liquid-rocketry-illinois/actuation-pcb/bom/actuation.xlsx

Reference | Value | Footprint | MPN | Digi-Key P/N | Qty | Inventory (https://docs.google.com/spreadsheets/d/1Jm4x6jHwPd06mLJlg_sdBbzIBf3uTwiiXO537uxlBAc/edit) | Order Qty | Notes
C1, C3, C23-C32, C35-C42, C45, C46, C48, C58, C59 | 0.1uF | Capacitor_SMD:C_0603_1608Metric | GRM188R72A104KA35D | 490-3285-1-ND | 25 | 80 | 50
C2, C4, C21, C22, C43, C44, C47, C57, C65, C66 | 1uF | Capacitor_SMD:C_0603_1608Metric | GRT188R61H105KE13D | 490-12330-1-ND | 10 | 80 | 50 | inventory rated for 25V
C5-C20 | 10uF | Capacitor_SMD:C_1210_3225Metric | CL32B106KBJNNWE | 1276-3388-1-ND | 16 | 4 | 24
C33, C34 | 1nF | Capacitor_SMD:C_0603_1608Metric | GCJ188R72A102KA01D | 490-5777-1-ND | 2 | 90 | 10
C49-C51 | 6.8nF | Capacitor_SMD:C_0603_1608Metric | GRM1885C1H682JA01D | 490-11477-1-ND | 3 | 0 | 10
C52, C53, C56 | 10uF | Capacitor_SMD:C_1206_3216Metric | CL31B106KBHNNNE | 1276-6767-1-ND | 3 | 4 | 10 | inventory rated for 50V
C54, C55 | 10nF | Capacitor_SMD:C_0603_1608Metric | GRT1885C1E103JA02J | 490-GRT1885C1E103JA02JCT-ND | 2 | 90 | 10 | inventory rated for 50V
C60 | 3.3nF | Capacitor_SMD:C_0603_1608Metric | GRM1885C1H332JA01D | 490-6385-1-ND | 1 | 0 | 10
C61 | 68nF | Capacitor_SMD:C_0603_1608Metric | GCJ188R71H683KA12D | 490-5799-1-ND | 1 | 0 | 10
C62, C63, C68 | 22uF | Capacitor_SMD:C_1206_3216Metric | GRM31CR71A226KE15L | 490-5309-1-ND | 3 | 6 | 10 | inventory rated for 10V
C64, C67 | 10uF | Capacitor_SMD:C_0805_2012Metric | GRM21BR71A106KA73L | 490-10516-1-ND | 2 | 80 | 10 | inventory rated for 25V
D1 | PESD5V0L1BA,115 | Diode_SMD:D_SOD-323 | PESD5V0L1BA,115 | 1727-3833-1-ND | 1 | 0 | 5
D2 | PESD3V3L1BA,115 | Diode_SMD:D_SOD-323 | PESD3V3L1BA,115 | 1727-3825-1-ND | 1 | 0 | 5
D3-D18, D46 | B2100A-13-F | Diode_SMD:D_SMA | B2100A-13-F | B2100A-13-FDICT-ND | 17 | 8 | 24
D19-D34 | ACT CH1-CH16 | LED_SMD:LED_0603_1608Metric | LTST-C191KFKT | 160-1445-1-ND | 16 | 0 | 24 | orange led
D35, D51, D44, D45, D47 | CHK FB/CTRL PWR/FB PWR/HOT PWR/COLD PWR | LED_SMD:LED_0603_1608Metric | LTST-C191KGKT | 160-1446-1-ND | 5 | 0 | 20 | have 3 of LTST-C190TGKT
D36, D48, D49 | CHK HOT/ARMED/ENERGIZE CTRL | LED_SMD:LED_0603_1608Metric | LTST-C191KRKT | 160-1447-1-ND | 3 | 0 | 10 | red led
D37-D42 | CHK SAF/FB CH1-CH3/VDET CH1-CH2 | LED_SMD:LED_0603_1608Metric | LTST-C191TBKT | 160-1647-1-ND | 6 | 8 | 20 | blue led
D43 | SMAJ40CA-13-F | Diode_SMD:D_SMA | SMAJ40CA-13-F | SMAJ40CA-FDICT-ND | 1 | 3 | 2
D50 | ENERGIZED | LED_SMD:LED_0603_1608Metric | LTW-C191DS5 | 160-2239-1-ND | 1 | 6 | 10 | white led
D52 | SMAJ28CAQ-13-F | Diode_SMD:D_SMA | SMAJ28CAQ-13-F | SMAJ28CAQ-13-FDICT-ND | 1 | 0 | 3
J1 | ACTUATION | actuation:182-009-213R561 | 182-009-213R561 | 182-109FE-ND | 1 | enough | 0 | DSUB
J2-J17 | ACT CH1-CH16 | actuation:XT30U-M | XT30U-M | ~ | 16 | 30 | 0 | LCSC
J18-J20 | FB CH1-CH3 | actuation:1935174 | 1935174 | 277-1578-ND | 3 | 0 | 10
J21-J22 | VDET CH1-CH2 | actuation:1935161 | 1935161 | 277-1667-ND | 2 | 0 | 10
J23, J26 | PWR IN/SAFETY | actuation:XT90PW-M | XT90PW-M | ~ | 2 | 4 | 0 | LCSC
J24-J25, J27-J29 | PWR PROT/PWR 3.3V/ACT HOT/ACT COLD | Connector_AMASS:AMASS_XT60-M_1x02_P7.20mm_Vertical | XT60-M | ~ | 5 | 20 | 0 | LCSC, 10 each of C98733 and C129184
K1 | J115F11C | actuation:J115F11C | J115F11CH12VDCSH1.5U | 2449-J115F11CH12VDCSH1.5U-ND | 1 | 1 | 2 | big relay
L1 | 4.7uH | Inductor_SMD:L_Vishay_IHLP-2020 | IHLP2020CZER4R7M11 | 541-1238-1-ND | 1 | 0 | 5
Q1 | SI7220 NMOS | Package_SO:Vishay_PowerPAK_1212-8_Dual | SI7220DN-T1-GE3 | SI7220DN-T1-GE3CT-ND | 1 | 1 | 3
Q2 | NMOS | Package_TO_SOT_SMD:SOT-23-3 | PMV40UN2R | 1727-1900-1-ND | 1 | 0 | 5
R2, R4, R5, R7 | 604R | Resistor_SMD:R_0603_1608Metric | RC0603FR-07604RL | 311-604HRCT-ND | 4 | 0 | 20
R3, R6 | 120R | Resistor_SMD:R_0603_1608Metric | RC0603FR-07120RL | 311-120HRCT-ND | 2 | 0 | 20
R8, R9, R68-R75, R93 | 4.7k | Resistor_SMD:R_0603_1608Metric | RT0603FRE074K7L | YAG1238CT-ND | 11 | 0 | 100
R10-R25, R42-R47, R54, R55, R82, R83, R94 | 270R | Resistor_SMD:R_0603_1608Metric | RC0603FR-07270RL | 311-270HRCT-ND | 27 | 0 | 100
R26-R41, R60-R67, R84, R95, R98 | 470R | Resistor_SMD:R_0603_1608Metric | RC0603FR-07470RL | 311-470HRCT-ND | 27 | 0 | 100
R48, R50, R90, R91 | 47k | Resistor_SMD:R_0603_1608Metric | RT0603DRE0747KL | 311-2592-1-ND | 4 | 0 | 20
R49, R51 | 20k | Resistor_SMD:R_0603_1608Metric | AT0603DRD0720KL | 311-2107-1-ND | 2 | 0 | 20
R52, R53, R56, R58 | 100k | Resistor_SMD:R_0603_1608Metric | RT0603DRE07100KL | 311-2395-1-ND | 4 | 0 | 20
R57, R59 | 13k | Resistor_SMD:R_0603_1608Metric | RT0603DRE0713KL | 311-2422-1-ND | 2 | 0 | 20
R76 | 1.87M | Resistor_SMD:R_0603_1608Metric | RC0603FR-071M87L | 13-RC0603FR-071M87LCT-ND | 1 | 90 | 0 | 1.87M 1% 1/10W 0603
R77 | 32.4k | Resistor_SMD:R_0603_1608Metric | RT0603BRD0732K4L | YAG1636CT-ND | 1 | 8 | 10 | 32.4k 0.1% 1/10W 0603
R78 | 510k | Resistor_SMD:R_0603_1608Metric | RC0603FR-07510KL | 311-510KHRCT-ND | 1 | 90 | 0 | 510k 1% 1/10W 0603
R79, R80 | 10R | Resistor_SMD:R_0603_1608Metric | RC0603FR-0710RL | 311-10.0HRCT-ND | 2 | 90 | 0 | 10 1% 1/10W 0603
R81 | 5.1k | Resistor_SMD:R_0603_1608Metric | AC0603FR-075K1L | YAG3621CT-ND | 1 | 8 | 10 | 5.1k 0.1% 1/10W 0.603
R85 | 200k | Resistor_SMD:R_0603_1608Metric | AC0603FR-07200KL | YAG3575CT-ND | 1 | 0 | 10
R86, R96, R97 | 10k | Resistor_SMD:R_0603_1608Metric | RC0603FR-0710KL | 311-10.0KHRCT-ND | 3 | 90 | 0 | 10k 1% 1/10W 0603
R87 | 9.31k | Resistor_SMD:R_0603_1608Metric | RT0603DRE079K31L | 311-2691-1-ND | 1 | 0 | 10
R88 | 69.8k | Resistor_SMD:R_0603_1608Metric | RT0603DRD0769K8L | 311-69.8KDCT-ND | 1 | 0 | 10
R89 | 22.1k | Resistor_SMD:R_0603_1608Metric | RT0603BRD0722K1L | YAG1590CT-ND | 1 | 0 | 10
R92 | 1k | Resistor_SMD:R_0603_1608Metric | RC0603FR-071KL | 311-1.00KHRCT-ND | 1 | 85 | 0 | 1k 1% 1/10W 0603
RV1, RV2 | 10k | Potentiometer_SMD:Potentiometer_Bourns_3224W_Vertical | 3224W-1-103E | 3224W-103ECT-ND | 2 | 0 | 4
U1 | TPD4E02B04DQA | Package_SON:USON-10_2.5x1.0mm_P0.5mm | TPD4E02B04DQAR | 296-43875-1-ND | 1 | 0 | 5 | TI sample?
U2 | PCA9615 | Package_SO:TSSOP-10_3x3mm_P0.5mm | PCA9615DPZ | 568-PCA9615DPZCT-ND | 1 | 4 | 0 | out of stock :(
U3-U18, U39 | TLP241A | actuation:TLP241A | TLP241A(TP1,F | TLP241A(TP1FCT-ND | 17 | 1 | 24
U19, U20, U33 | PCA9534 | Package_SO:TSSOP-16_4.4x5mm_P0.65mm | PCA9534PWR | 296-21764-1-ND | 3 | 0 | 6 | TI sample?
U21-U26, U29, U30 | TLP2366 | actuation:TLP2366 | TLP2366(V4-TPL,E | TLP2366(V4-TPLECT-ND | 8 | 0 | 12
U27, U28 | TLV7031 | Package_TO_SOT_SMD:SOT-353_SC-70-5 | TLV7031QDCKRQ1 | 296-TLV7031QDCKRQ1CT-ND | 2 | 0 | 6 | TI sample?
U31, U32 | 74LVC1G126 | Package_TO_SOT_SMD:SOT-23-5 | 74LVC1G126GV,125 | 1727-6066-1-ND | 2 | 0 | 6
U34 | SN74LVC541A | Package_SO:TSSOP-20_4.4x6.5mm_P0.65mm | SN74LVC541APWR | 296-8521-1-ND | 1 | 0 | 3 | TI sample?
U35 | TLI4971 | Package_SON:Infineon_PG-TISON-8-5 | TLI4971A050T5UE0001XUMA1 | 448-TLI4971A050T5UE0001XUMA1CT-ND | 1 | 0 | 2
U36 | LTC4367 | Package_DFN_QFN:DFN-8-1EP_3x3mm_P0.5mm_EP1.65x2.38mm | LTC4367IDD-1#PBF | 505-LTC4367IDD-1#PBF-ND | 1 | 3 | 0 | out of stock :( Analog sample?
U37 | ADS1110 | Package_TO_SOT_SMD:SOT-23-6 | ADS1110A1IDBVT | 296-14462-1-ND | 1 | 0 | 2 | TI sample?
U38 | AP64350 | Package_SO:SOIC-8-1EP_3.9x4.9mm_P1.27mm_EP2.62x3.51mm | AP64350SP-13 | 31-AP64350SP-13CT-ND | 1 | 0 | 3
U40 | LP5912-3.3DRV | Package_SON:WSON-6-1EP_2x2mm_P0.65mm_EP1x1.6mm | LP5912-3.3DRVR | 296-47214-1-ND | 1 | 0 | 3 | TI sample?
 |  |  |  |  |  | Digi-Key cart | https://www.digikey.com/short/b8pdp9ph
