liquid-rocketry-illinois/actuation-pcb/actuation-3d/SI7220DN-T1-GE3.step

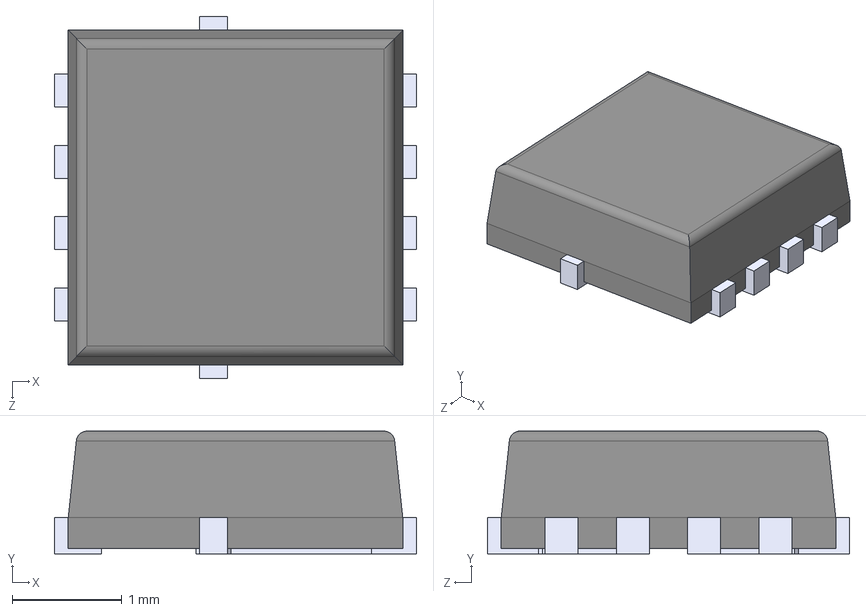
[picture p1: CAD file, 2023-03-06]
actuation-3d/SI7220DN-T1-GE3.step
3.30 x 1.12 x 3.30 mm
