liquid-rocketry-illinois/actuation-pcb/actuation-3d/3224W-1-103E.step

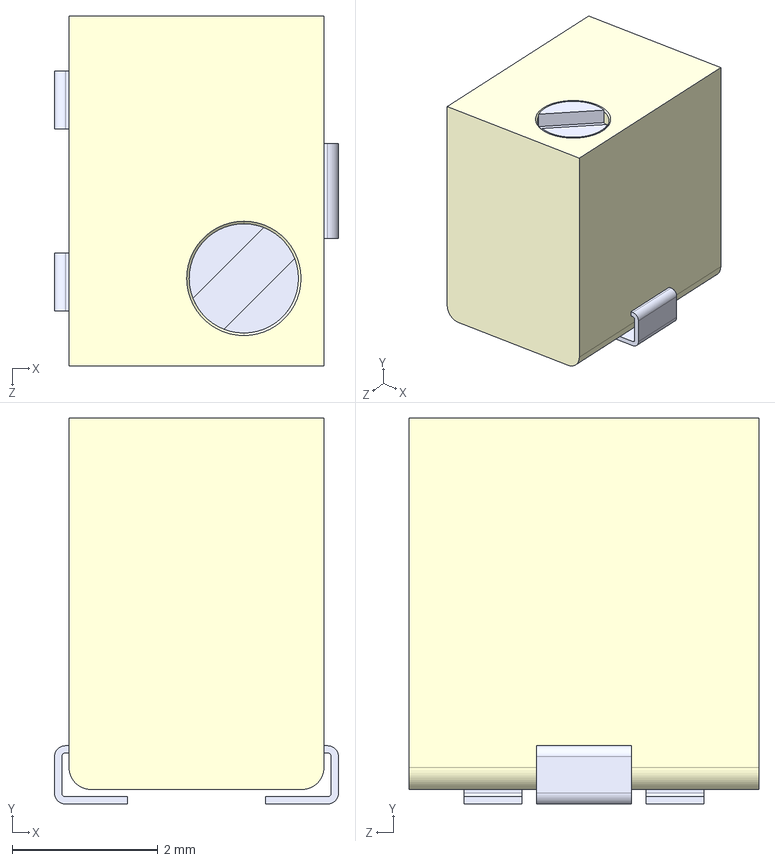
[picture p2: CAD file, 2023-01-27]
actuation-3d/3224W-1-103E.step
3.90 x 5.30 x 4.80 mm
