liquid-rocketry-illinois/actuation-pcb/actuation-3d/Relay_J115F.step

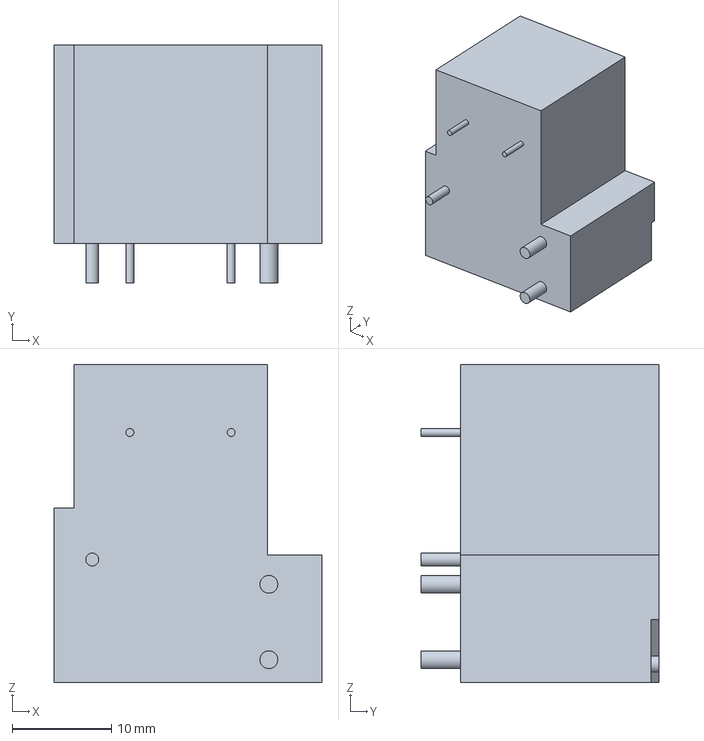
[picture p3: CAD file, 2023-01-24]
actuation-3d/Relay_J115F.step
27.0 x 24.0 x 32.0 mm
