liquid-rocketry-illinois/actuation-pcb/actuation-3d/XT30U-M.step

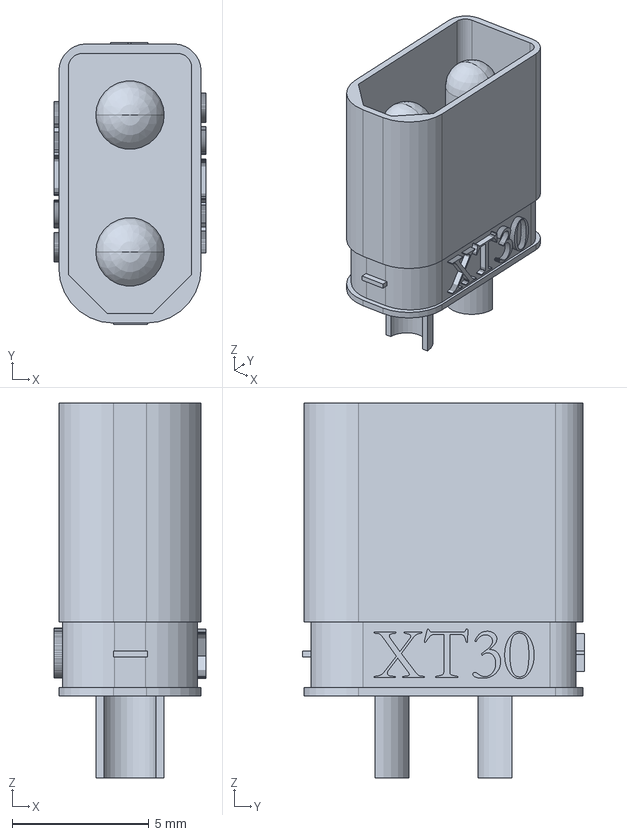
[picture p4: CAD file, 2023-01-22]
actuation-3d/XT30U-M.step
5.54 x 10.3 x 13.7 mm
