liquid-rocketry-illinois/actuation-pcb/actuation-3d/XT90PW-M-new.step

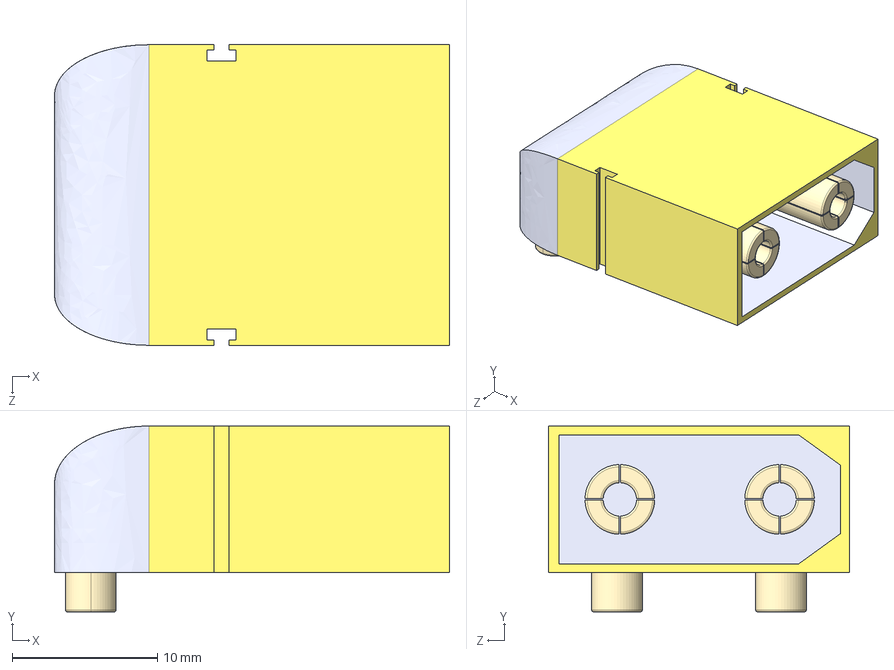
[picture p5: CAD file, 2023-01-16]
actuation-3d/XT90PW-M-new.step
27.2 x 12.8 x 20.7 mm
