liquid-rocketry-illinois/actuation-pcb/actuation-3d/XT90PW-M.step

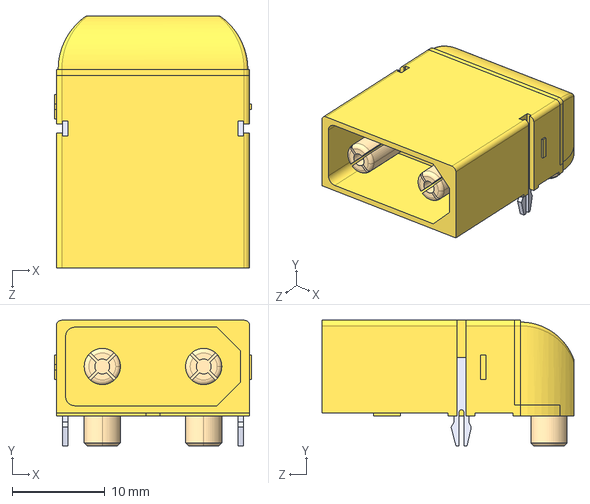
[picture p6: CAD file, 2023-01-16]
actuation-3d/XT90PW-M.step
21.2 x 13.5 x 27.1 mm
