liquid-rocketry-illinois/actuation-pcb/actuation-3d/IHLP2020.step

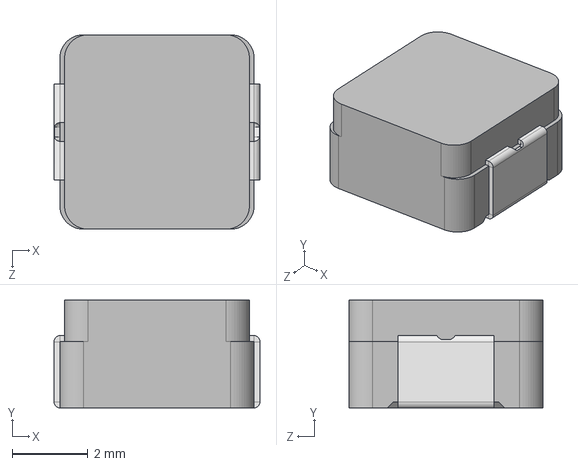
[picture p7: CAD file, 2023-01-06]
actuation-3d/IHLP2020.step
5.45 x 2.86 x 5.15 mm
