liquid-rocketry-illinois/actuation-pcb/actuation-3d/182-009-213.step

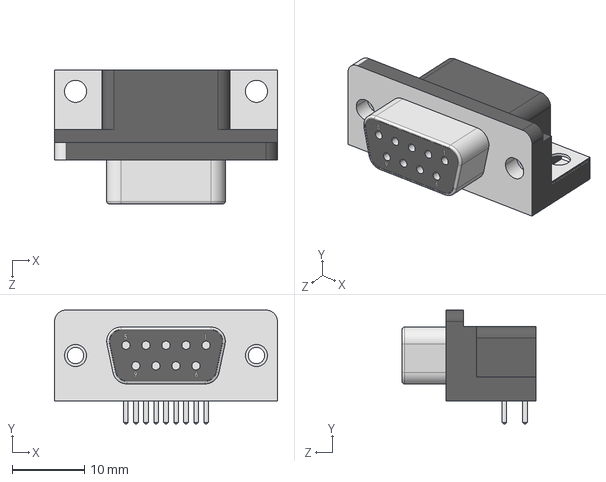
[picture p8: CAD file, 2023-01-06]
actuation-3d/182-009-213.step
30.8 x 15.7 x 18.5 mm
