liquid-rocketry-illinois/actuation-pcb/actuation-3d/TLP2366.step

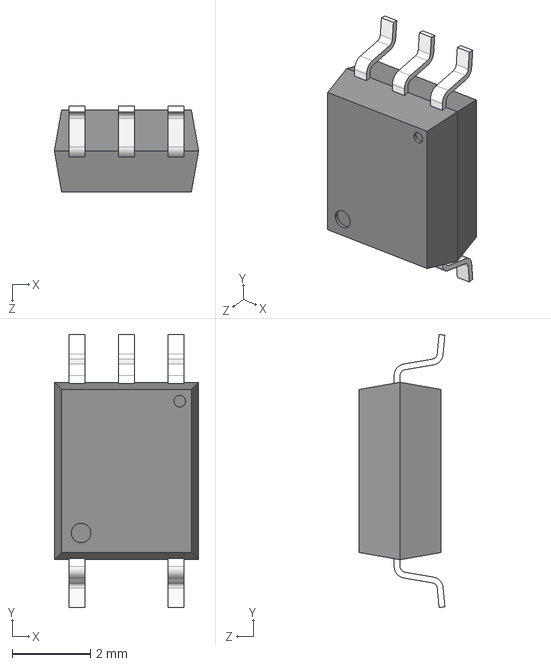
[picture p9: CAD file, 2023-01-06]
actuation-3d/TLP2366.step
3.70 x 7.00 x 2.20 mm
