liquid-rocketry-illinois/actuation-pcb/actuation-3d/TLI4971A050T5UE0001XUMA1--3DModel-STEP-56544.step

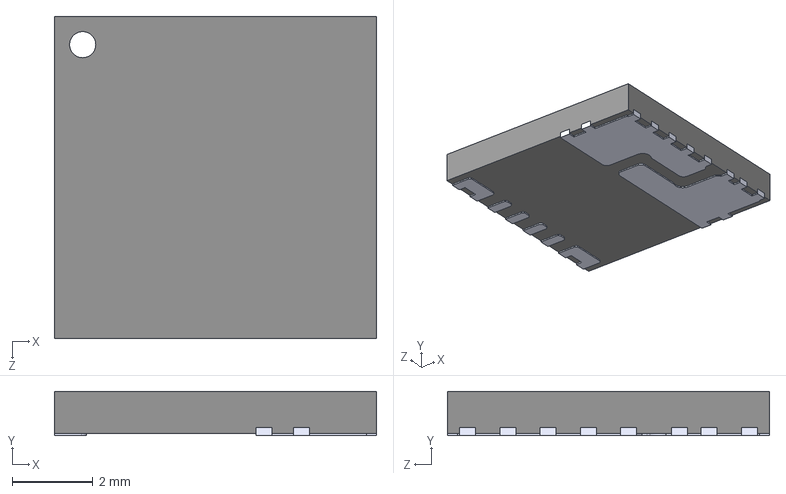
[picture p10: CAD file, 2023-01-06]
actuation-3d/TLI4971A050T5UE0001XUMA1--3DModel-STEP-56544.step
8.00 x 1.10 x 8.00 mm
