liquid-rocketry-illinois/actuation-pcb/actuation-3d/TLP241A.step

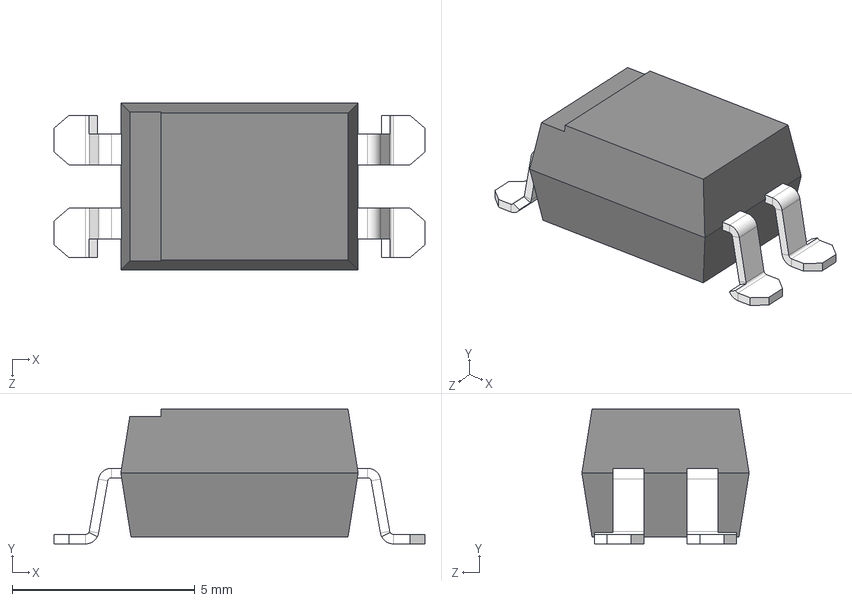
[picture p11: CAD file, 2023-01-06]
actuation-3d/TLP241A.step
10.2 x 3.69 x 4.58 mm
