liquid-rocketry-illinois/actuation-pcb/actuation-3d/1935161.step

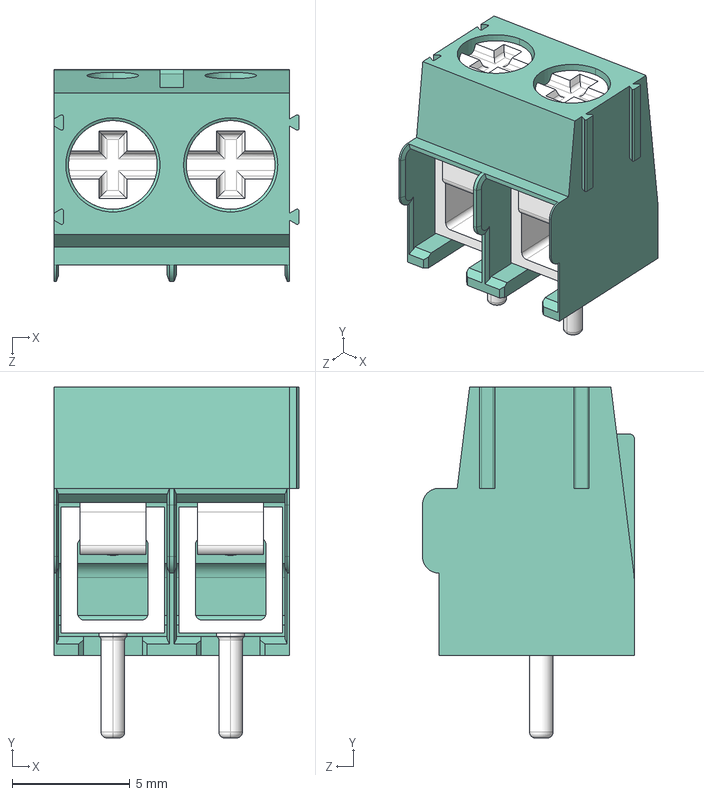
[picture p12: CAD file, 2023-01-22]
actuation-3d/1935161.step
10.4 x 14.9 x 9.00 mm
