liquid-rocketry-illinois/actuation-pcb/actuation-3d/1935174.step

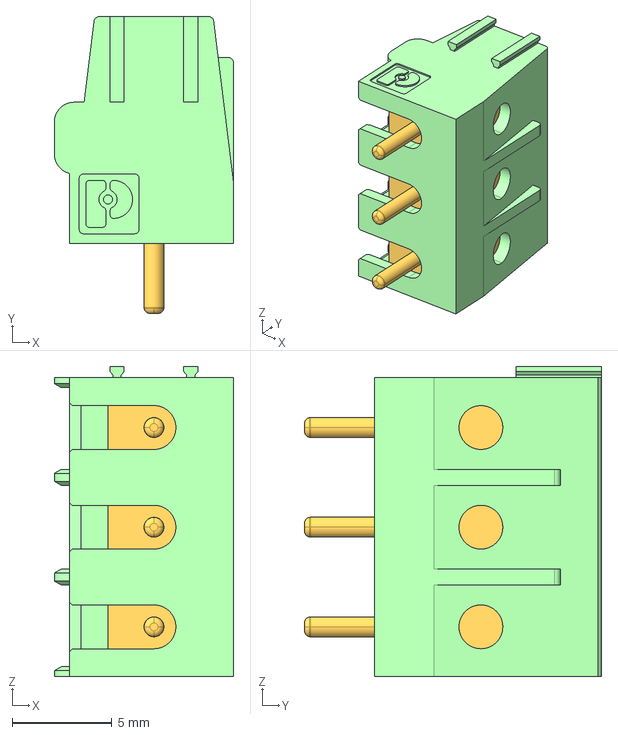
[picture p13: CAD file, 2023-01-22]
actuation-3d/1935174.step
9.00 x 14.9 x 15.6 mm
