liquid-rocketry-illinois/actuation-pcb/actuation-3d/1751251.step

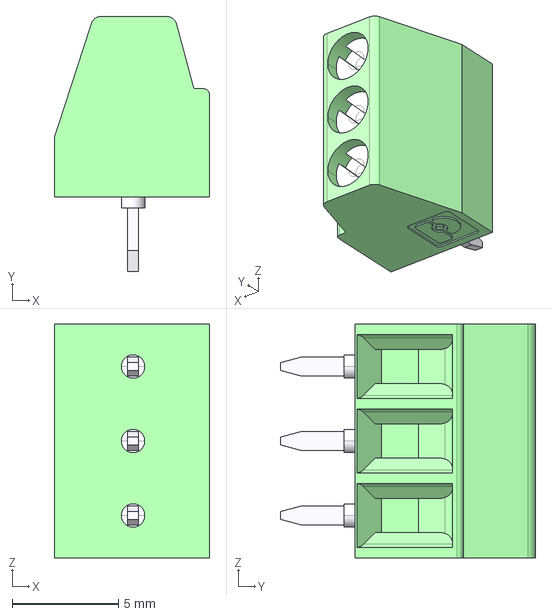
[picture p14: CAD file, 2023-01-04]
actuation-3d/1751251.step
7.30 x 12.0 x 11.0 mm
