liquid-rocketry-illinois/actuation-pcb/actuation-3d/1773976.step

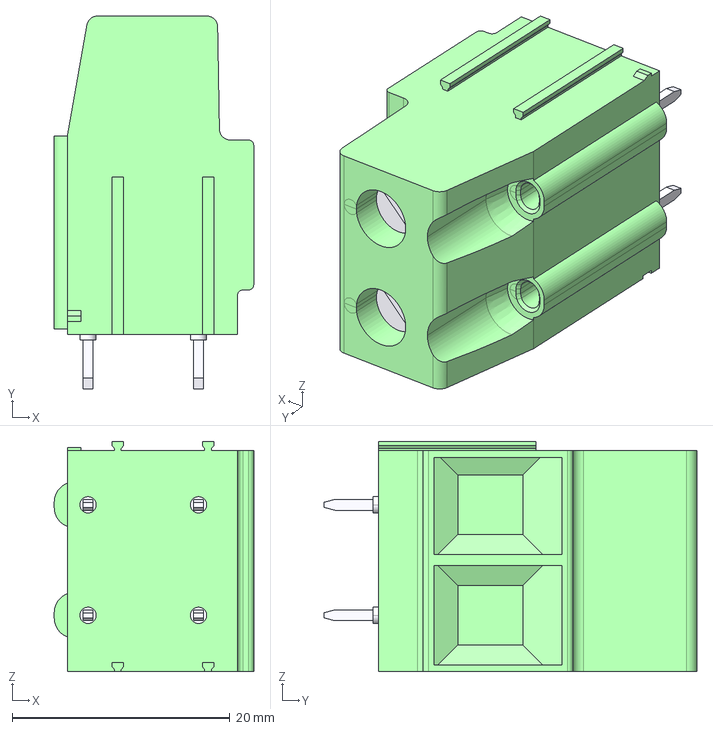
[picture p15: CAD file, 2023-01-04]
actuation-3d/1773976.step
18.4 x 34.3 x 21.2 mm
