liquid-rocketry-illinois/actuation-pcb/actuation-3d/1751248.step

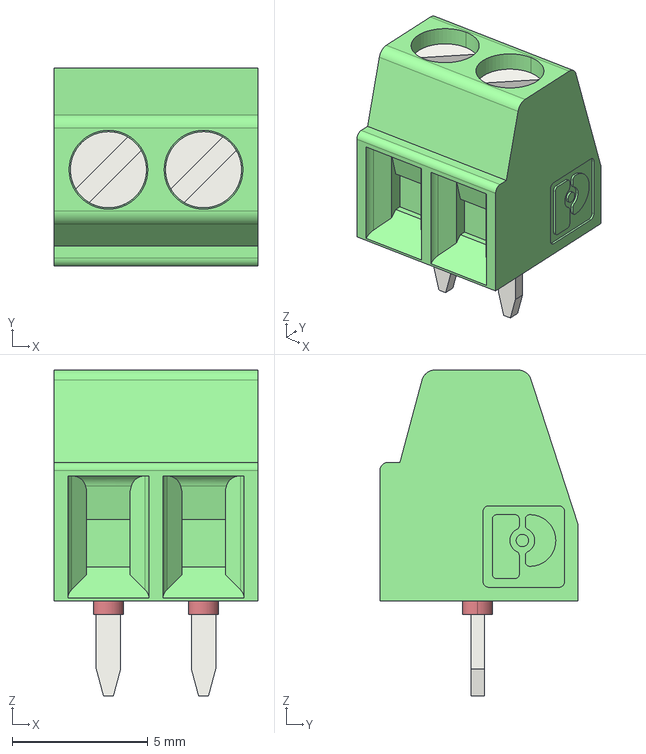
[picture p16: CAD file, 2023-01-04]
actuation-3d/1751248.step
7.50 x 7.30 x 12.0 mm
