liquid-rocketry-illinois/actuation-pcb/actuation.pdf

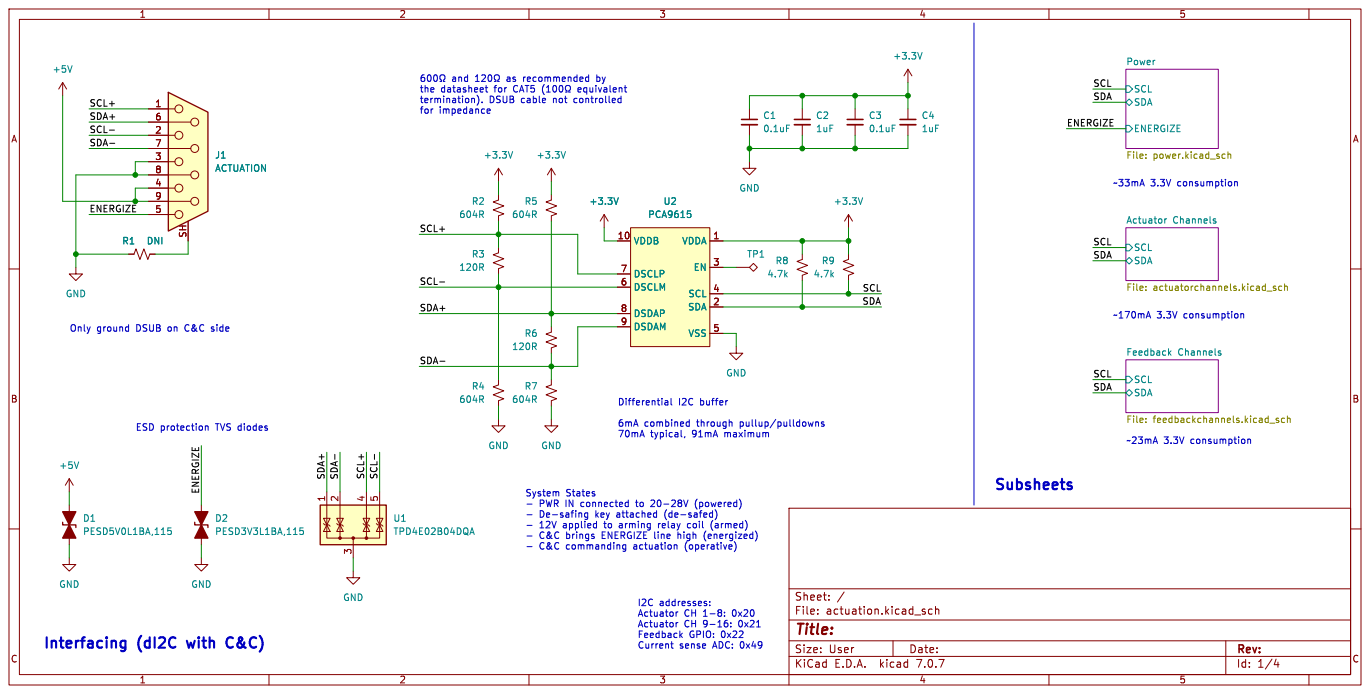
[picture p17: page 1]

Power File: power.kicad_sch GND

SCL Actuator Channels File: actuatorchannels.kicad_sch SCL SDA

Feedback Channels File: feedbackchannels.kicad_sch SDA

Only ground DSUB on C&C side

- 12V applied to arming relay coil (armed)
- C&C brings ENERGIZE line high (energized)

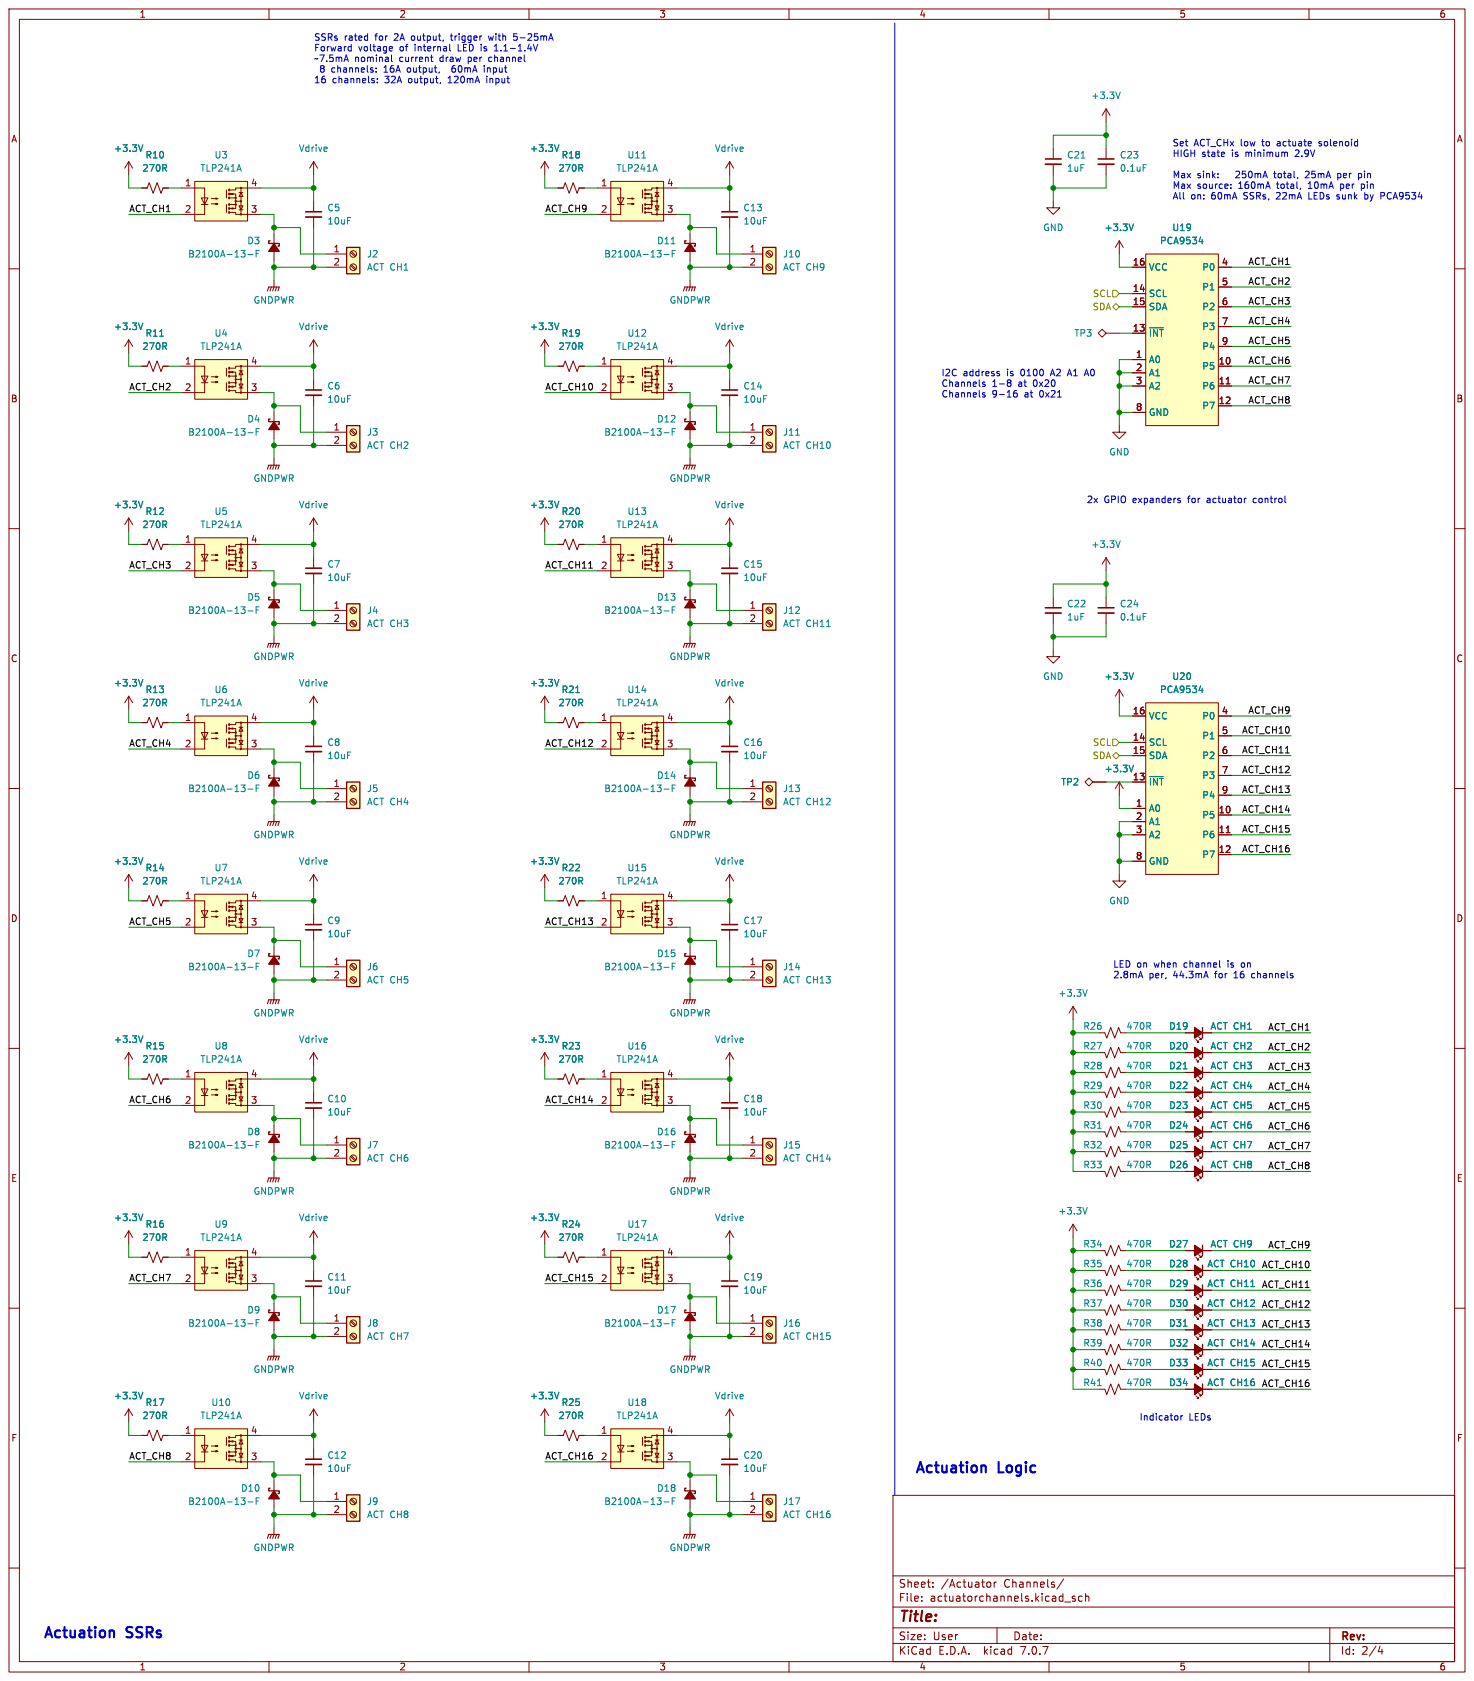
[picture p18: page 2]

SSRs rated for 2A output, trigger with 5-25mA

LED on when channel is on
2.8mA per, 44.3mA for 16 channels

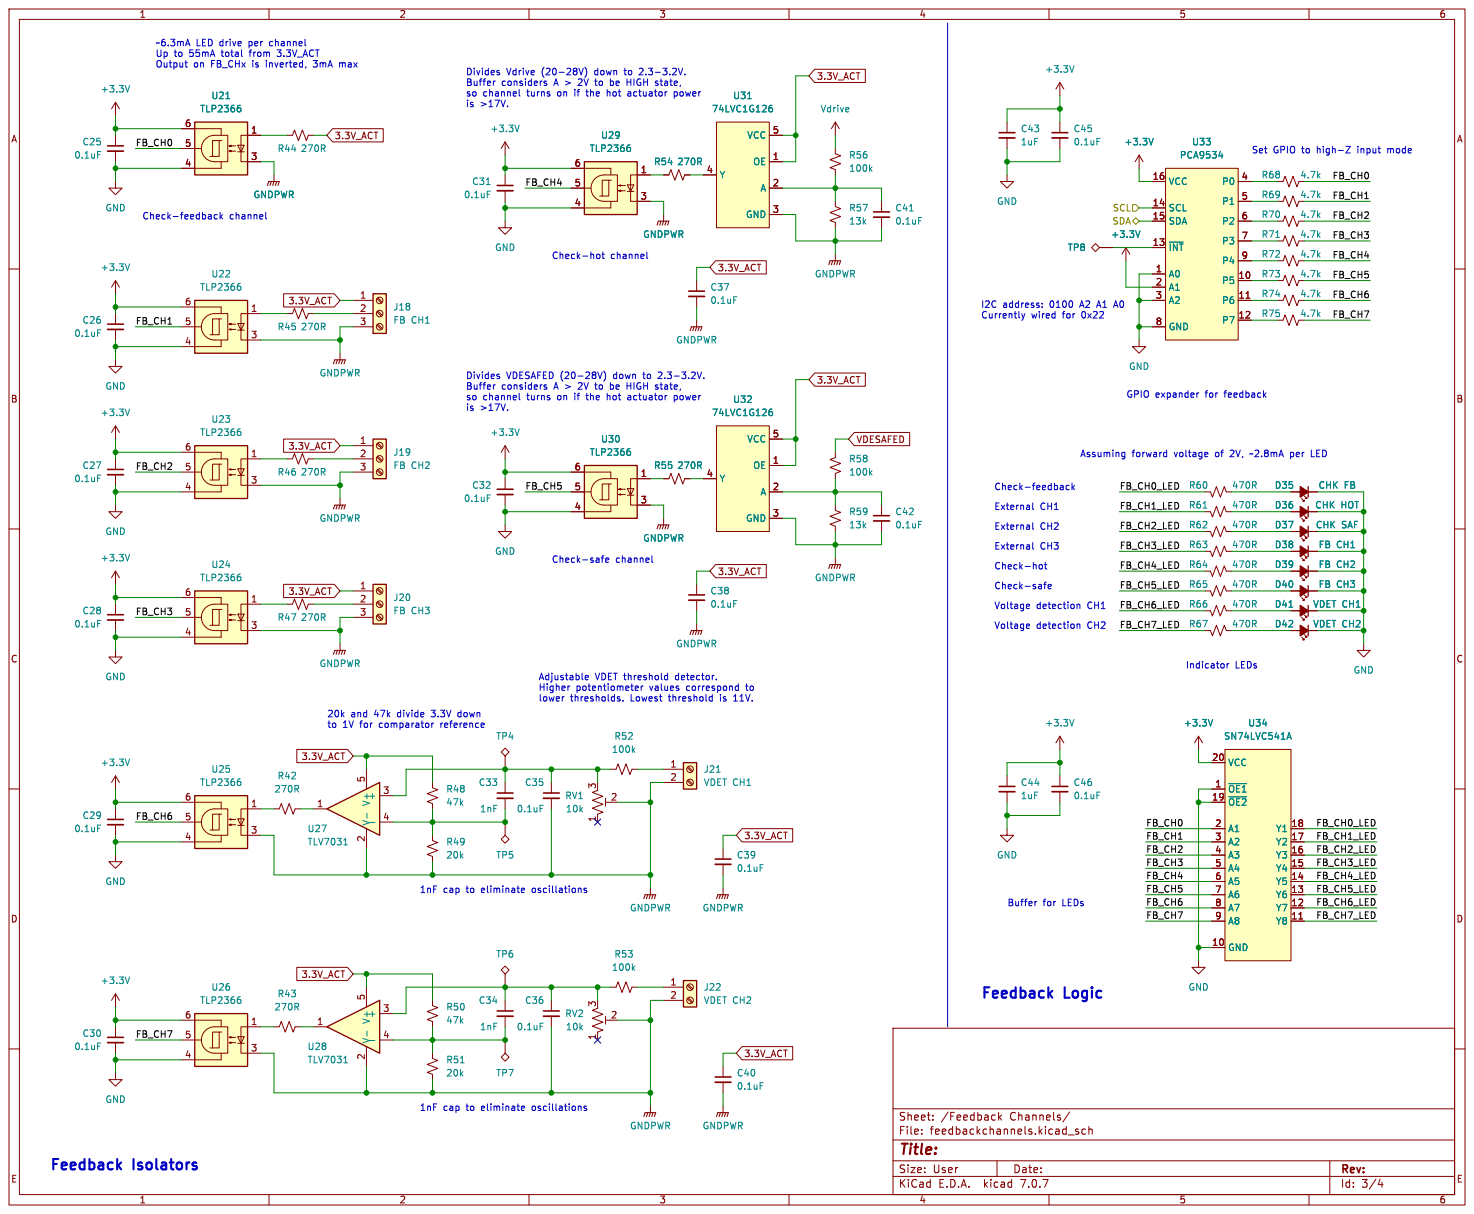
[picture p19: page 3]

Buffer for LEDs Feedback Logic

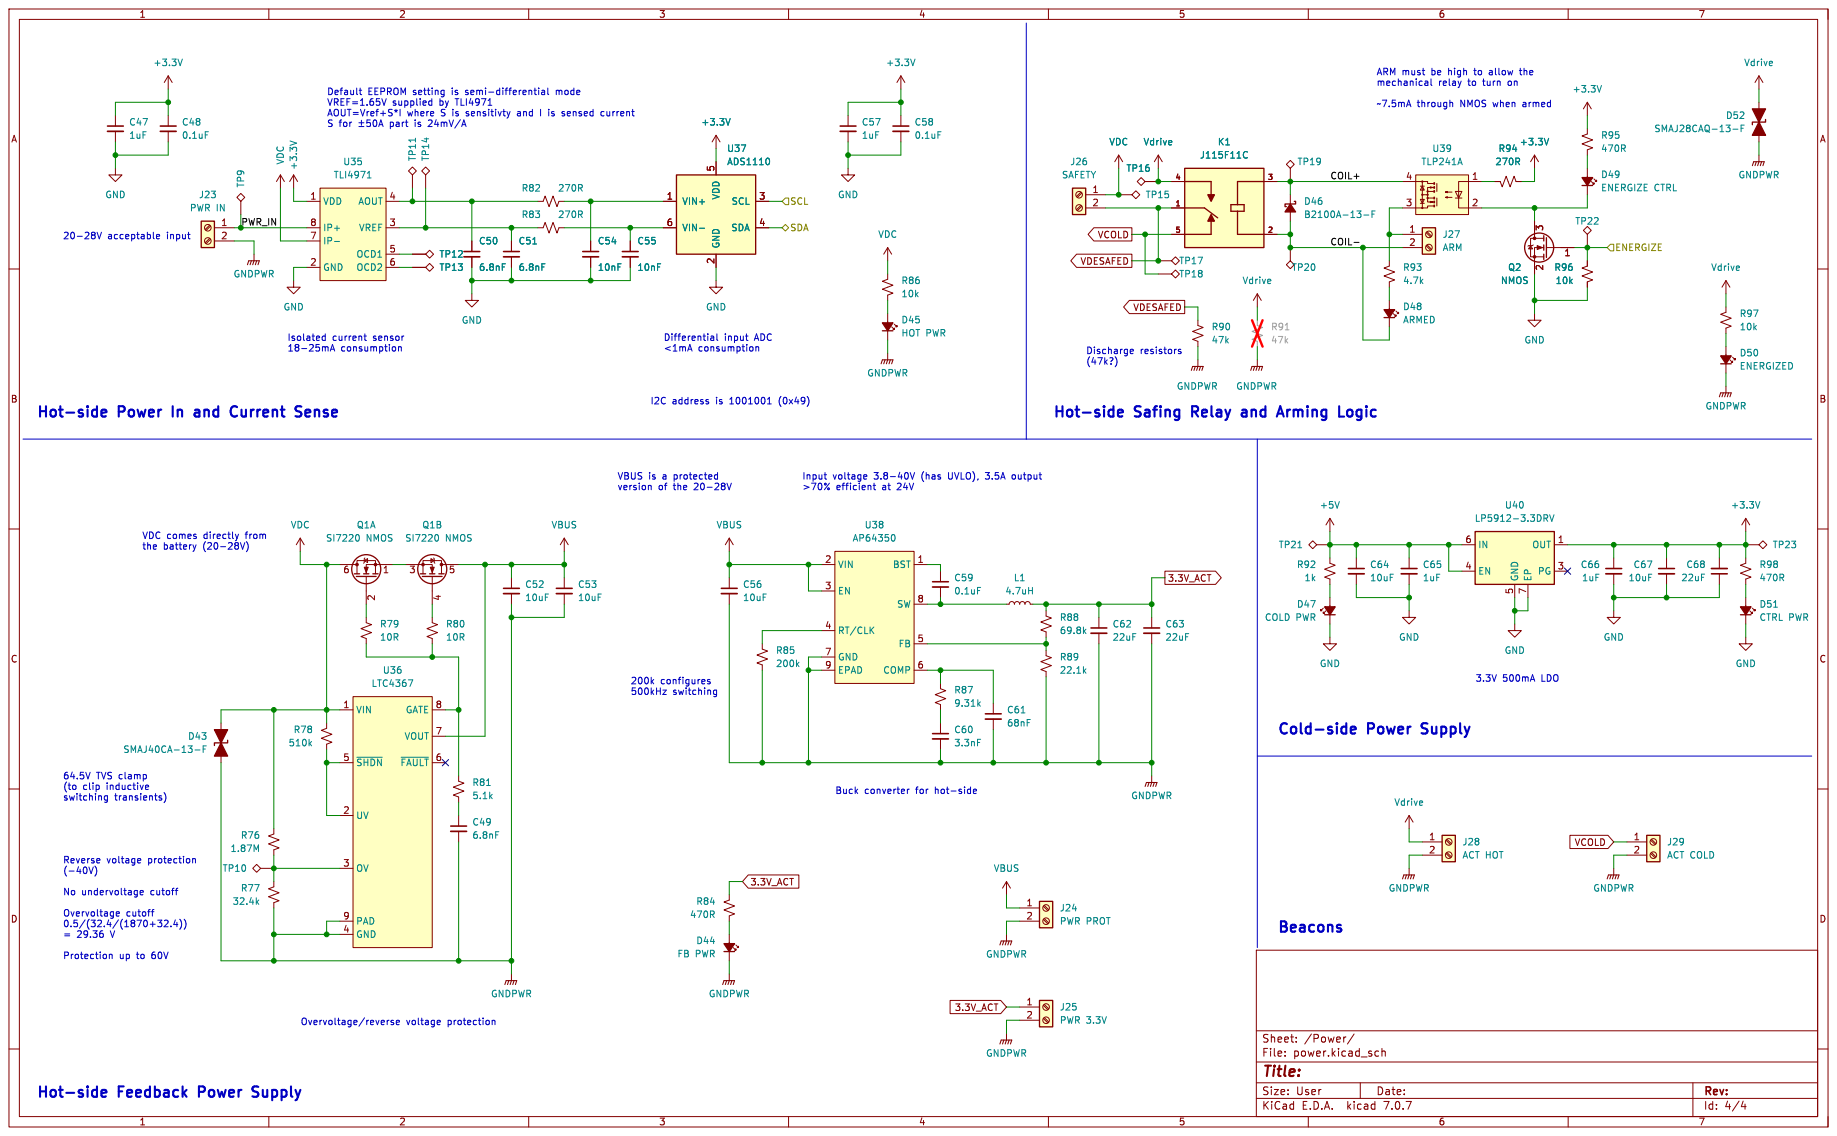
[picture p20: page 4]

COIL+ PWR_IN
Id: 4/4 Title: File: power.kicad_sch Sheet: /Power/ TP9

COIL- VBUS is a protected
