liquid-rocketry-illinois/actuation-pcb/actuation.kicad_pcb

## KiCad design actuation.kicad_pcb (2023-03-16)

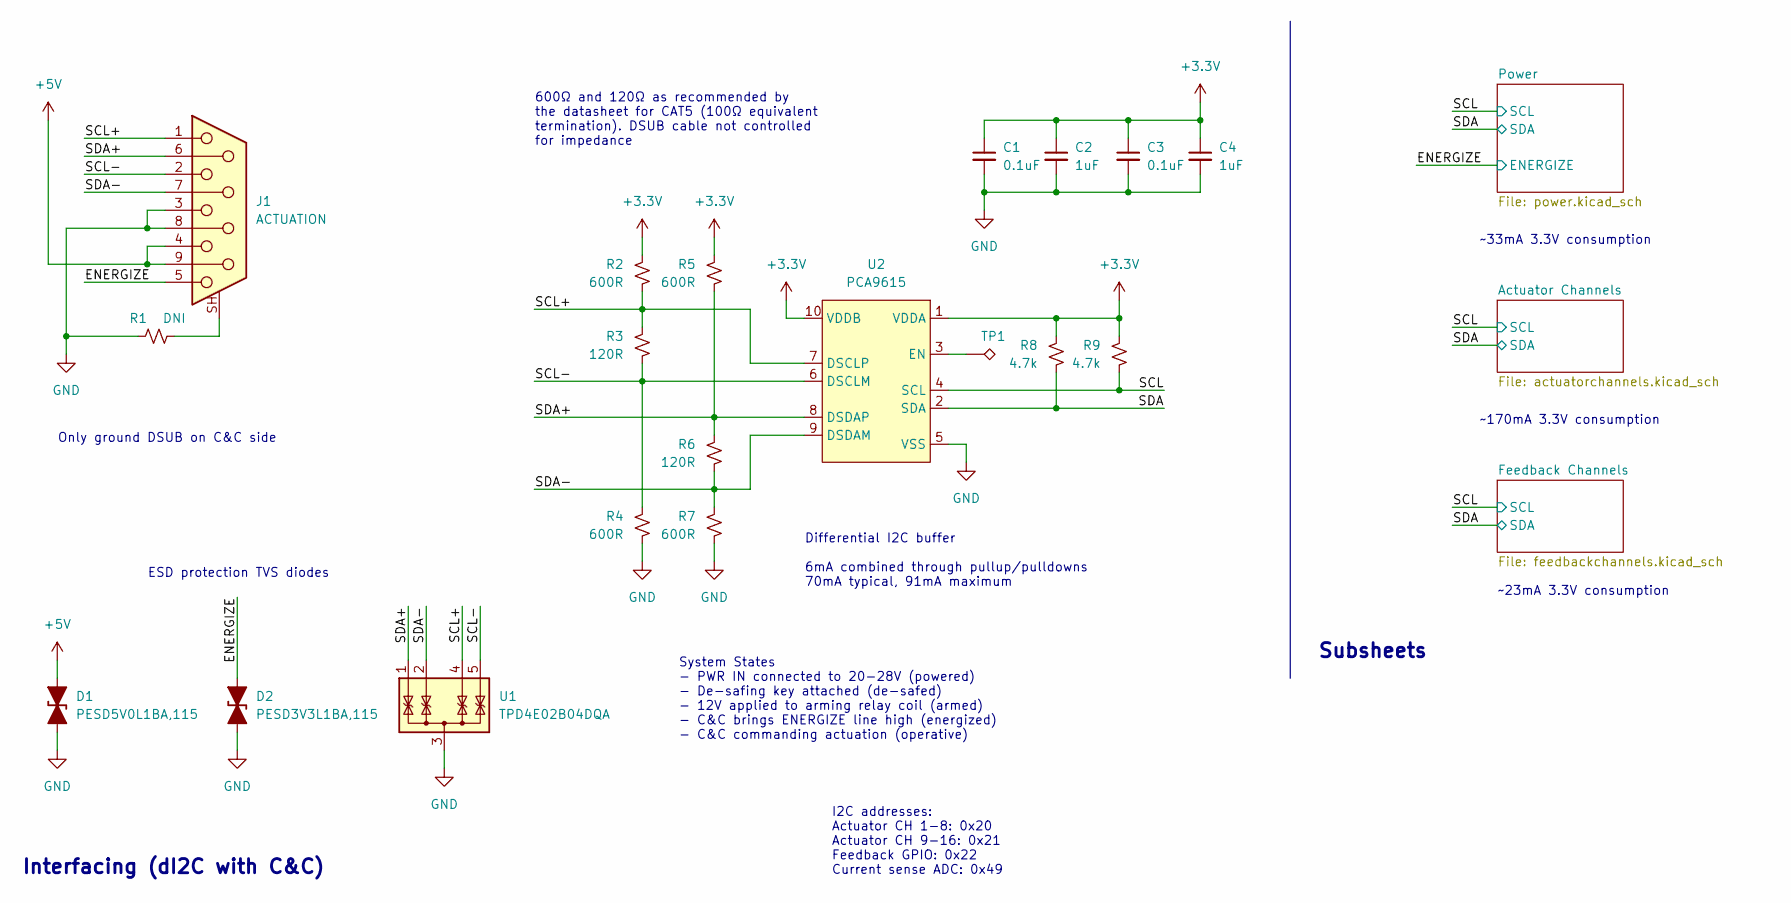
[picture p21: schematic actuation.kicad_sch]

Parts:
C1, C3: 0.1uF; C_0603_1608Metric
C2, C4: 1uF; C_0603_1608Metric
D1: PESD5V0L1BA,115; D_SOD-323; MPN PESD3V3L1BA,115
D2: PESD3V3L1BA,115; D_SOD-323; MPN PESD3V3L1BA,115
J1: ACTUATION; 182-009-213R561; MPN 182-009-213R561
R1: DNI; R_0603_1608Metric; MPN RC0603JR-070RL
R2, R4, R5, R7: 600R; R_0603_1608Metric
R3, R6: 120R; R_0603_1608Metric
R8, R9: 4.7k; R_0603_1608Metric
TP1: TestPoint_Alt; TestPoint_Pad_D2.0mm
U1: TPD4E02B04DQA; USON-10_2.5x1.0mm_P0.5mm; MPN TPD4E02B04DQAR
U2: PCA9615; TSSOP-10_3x3mm_P0.5mm; MPN PCA9615DPZ

Connections:
+3.3V: C1.1, C2.1, C3.1, C4.1, R2.1, R5.1, R8.1, R9.1, U2.1 (VDDA), U2.10 (VDDB); also elsewhere on the board
+5V: D1.2 (A2), J1.4, J1.9; also elsewhere on the board
/ENERGIZE: D2.2 (A2), J1.5; also elsewhere on the board
/SCL: R9.2, U2.4 (SCL); also elsewhere on the board
/SCL+: J1.1, R2.2, R3.1, U1.4 (IO3), U2.7 (DSCLP)
/SCL-: J1.2, R3.2, R4.1, U1.5 (IO4), U2.6 (DSCLM)
/SDA: R8.2, U2.2 (SDA); also elsewhere on the board
/SDA+: J1.6, R5.2, R6.1, U1.1 (IO1), U2.8 (DSDAP)
/SDA-: J1.7, R6.2, R7.1, U1.2 (IO2), U2.9 (DSDAM)
GND: C1.2, C2.2, C3.2, C4.2, D1.1 (A1), D2.1 (A1), J1.3, J1.8, R1.1, R4.2, R7.2, U1.3 (G), U1.8 (G), U2.5 (VSS); also elsewhere on the board
unnamed: J1.SH (PAD), R1.2
unnamed: TP1.1, U2.3 (EN)

Notes on the sheet:
~170mA 3.3V consumption
Interfacing (dI2C with C&C)
Subsheets
600Ω and 120Ω as recommended by the datasheet for CAT5 (100Ω equivalent termination). DSUB cable not controlled for impedance
~23mA 3.3V consumption
Only ground DSUB on C&C side
I2C addresses: Actuator CH 1-8: 0x20 Actuator CH 9-16: 0x21 Feedback GPIO: 0x22 Current sense ADC: 0x49
ESD protection TVS diodes
~33mA 3.3V consumption
System States - PWR IN connected to 20-28V (powered) - De-safing key attached (de-safed) - 12V applied to arming relay coil (armed) - C&C brings ENERGIZE line high (energized) - C&C commanding actuation (operative)
Differential I2C buffer 6mA combined through pullup/pulldowns 70mA typical, 91mA maximum

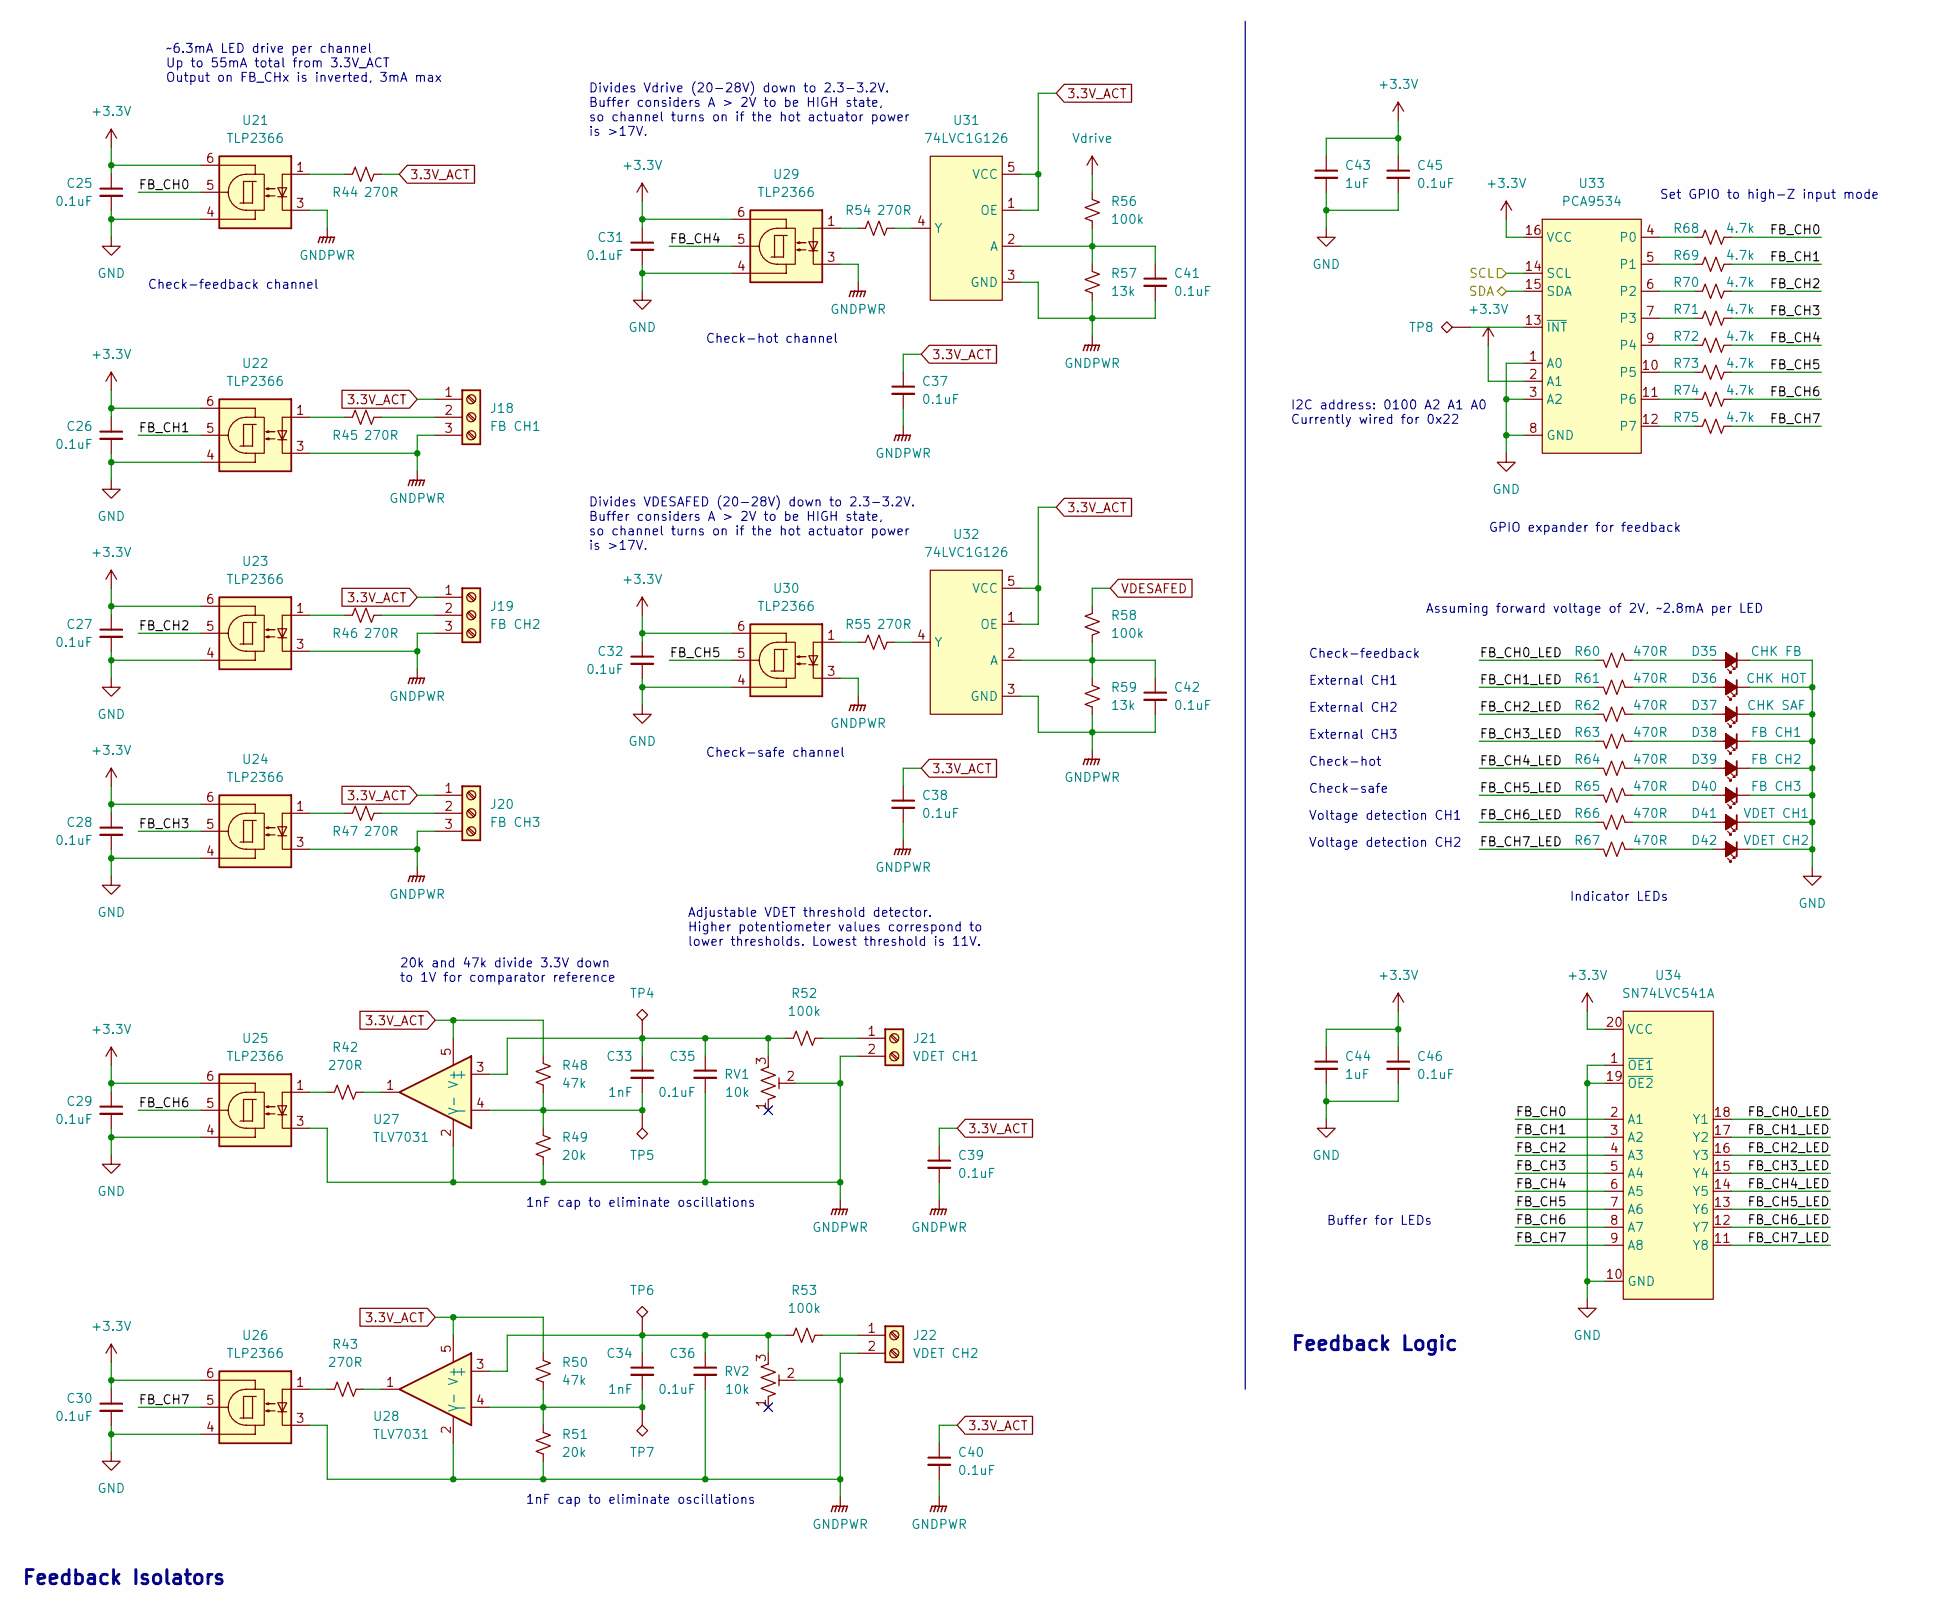
[picture p22: schematic feedbackchannels.kicad_sch]

Parts:
C25, C26, C27, C28, C29, C30, C31, C32, C35, C36, C37, C38, C39, C40, C41, C42, C45, C46: 0.1uF; C_0603_1608Metric
C33, C34: 1nF; C_0603_1608Metric
C43, C44: 1uF; C_0603_1608Metric
D35: CHK FB; LED_0603_1608Metric; MPN LTST-C191KGKT
D36: CHK HOT; LED_0603_1608Metric; MPN LTST-C191KRKT
D37: CHK SAF; LED_0603_1608Metric; MPN LTST-C191TBKT
D38: FB CH1; LED_0603_1608Metric; MPN LTST-C191TBKT
D39: FB CH2; LED_0603_1608Metric; MPN LTST-C191TBKT
D40: FB CH3; LED_0603_1608Metric; MPN LTST-C191TBKT
D41: VDET CH1; LED_0603_1608Metric; MPN LTST-C191TBKT
D42: VDET CH2; LED_0603_1608Metric; MPN LTST-C191TBKT
J18: FB CH1; 1935174; MPN 1935174
J19: FB CH2; 1935174; MPN 1935174
J20: FB CH3; 1935174; MPN 1935174
J21: VDET CH1; 1935161; MPN 1935161
J22: VDET CH2; 1935161; MPN 1935161
R42, R43, R44, R45, R46, R47, R54, R55: 270R; R_0603_1608Metric; MPN RC0603FR-07270RL
R48, R50: 47k; R_0603_1608Metric
R49, R51: 20k; R_0603_1608Metric
R52, R53, R56, R58: 100k; R_0603_1608Metric
R57, R59: 13k; R_0603_1608Metric
R60, R61, R62, R63, R64, R65, R66, R67: 470R; R_0603_1608Metric
R68, R69, R70, R71, R72, R73, R74, R75: 4.7k; R_0603_1608Metric
RV1, RV2: 10k; Potentiometer_Bourns_3224W_Vertical; MPN 3224W-1-103E
TP4, TP5, TP6, TP7, TP8: TestPoint_Alt; TestPoint_Pad_D2.0mm
U21, U22, U23, U24, U25, U26, U29, U30: TLP2366; MPN TLP2366(V4-TPL,E
U27, U28: TLV7031; SOT-353_SC-70-5; MPN TLV7031QDCKRQ1
U31, U32: 74LVC1G126; SOT-23-5; MPN 74LVC1G126GV,125
U33: PCA9534; TSSOP-16_4.4x5mm_P0.65mm; MPN PCA9534PWR
U34: SN74LVC541A; TSSOP-20_4.4x6.5mm_P0.65mm; MPN SN74LVC541APWR

Connections:
3.3V_ACT: C37.1, C38.1, C39.1, C40.1, J18.1, J19.1, J20.1, R44.2, R48.1, R50.1, U27.5 (V+), U28.5 (V+), U31.1 (OE), U31.5 (VCC), U32.1 (OE), U32.5 (VCC); also elsewhere on the board
+3.3V: C25.1, C26.1, C27.1, C28.1, C29.1, C30.1, C31.1, C32.1, C43.1, C44.1, C45.1, C46.1, U21.6, U22.6, U23.6, U24.6, U25.6, U26.6, U29.6, U30.6, U33.2 (A1), U33.16 (VCC), U34.20 (VCC); also elsewhere on the board
/Feedback Channels/FB_CH0: R68.2, U21.5, U34.2 (A1)
/Feedback Channels/FB_CH0_LED: R60.1, U34.18 (Y1)
/Feedback Channels/FB_CH1: R69.2, U22.5, U34.3 (A2)
/Feedback Channels/FB_CH1_LED: R61.1, U34.17 (Y2)
/Feedback Channels/FB_CH2: R70.2, U23.5, U34.4 (A3)
/Feedback Channels/FB_CH2_LED: R62.1, U34.16 (Y3)
/Feedback Channels/FB_CH3: R71.2, U24.5, U34.5 (A4)
/Feedback Channels/FB_CH3_LED: R63.1, U34.15 (Y4)
/Feedback Channels/FB_CH4: R72.2, U29.5, U34.6 (A5)
/Feedback Channels/FB_CH4_LED: R64.1, U34.14 (Y5)
/Feedback Channels/FB_CH5: R73.2, U30.5, U34.7 (A6)
/Feedback Channels/FB_CH5_LED: R65.1, U34.13 (Y6)
/Feedback Channels/FB_CH6: R74.2, U25.5, U34.8 (A7)
/Feedback Channels/FB_CH6_LED: R66.1, U34.12 (Y7)
/Feedback Channels/FB_CH7: R75.2, U26.5, U34.9 (A8)
/Feedback Channels/FB_CH7_LED: R67.1, U34.11 (Y8)
/SCL: U33.14 (SCL); also elsewhere on the board
/SDA: U33.15 (SDA); also elsewhere on the board
GND: C25.2, C26.2, C27.2, C28.2, C29.2, C30.2, C31.2, C32.2, C43.2, C44.2, C45.2, C46.2, D35.1 (K), D36.1 (K), D37.1 (K), D38.1 (K), D39.1 (K), D40.1 (K), D41.1 (K), D42.1 (K), U21.4, U22.4, U23.4, U24.4, U25.4, U26.4, U29.4, U30.4, U33.1 (A0), U33.3 (A2), U33.8 (GND), U34.1 (~OE1), U34.10 (GND), U34.19 (~OE2); also elsewhere on the board
GNDPWR: C35.2, C36.2, C37.2, C38.2, C39.2, C40.2, C41.2, C42.2, J18.3, J19.3, J20.3, J21.2, J22.2, R49.2, R51.2, R57.2, R59.2, RV1.2, RV2.2, U21.3, U22.3, U23.3, U24.3, U25.3, U26.3, U27.2 (V-), U28.2 (V-), U29.3, U30.3, U31.3 (GND), U32.3 (GND); also elsewhere on the board
unnamed: C33.1, C35.1, R52.1, RV1.3, TP4.1, U27.3 (+)
unnamed: C33.2, R48.2, R49.1, TP5.1, U27.4 (-)
unnamed: C34.1, C36.1, R53.1, RV2.3, TP6.1, U28.3 (+)
unnamed: C34.2, R50.2, R51.1, TP7.1, U28.4 (-)
unnamed: C41.1, R56.2, R57.1, U31.2 (A)
unnamed: C42.1, R58.2, R59.1, U32.2 (A)
unnamed: D35.2 (A), R60.2
unnamed: D36.2 (A), R61.2
unnamed: D37.2 (A), R62.2
unnamed: D38.2 (A), R63.2
unnamed: D39.2 (A), R64.2
unnamed: D40.2 (A), R65.2
unnamed: D41.2 (A), R66.2
unnamed: D42.2 (A), R67.2
unnamed: J18.2, R45.2
unnamed: J19.2, R46.2
unnamed: J20.2, R47.2
unnamed: J21.1, R52.2
unnamed: J22.1, R53.2
unnamed: R42.1, U25.1
unnamed: R42.2, U27.1
unnamed: R43.1, U26.1
unnamed: R43.2, U28.1
unnamed: R44.1, U21.1
unnamed: R45.1, U22.1
unnamed: R46.1, U23.1
unnamed: R47.1, U24.1
unnamed: R54.1, U31.4 (Y)
unnamed: R54.2, U29.1
unnamed: R55.1, U32.4 (Y)
unnamed: R55.2, U30.1
unnamed: R68.1, U33.4 (P0)
unnamed: R69.1, U33.5 (P1)
unnamed: R70.1, U33.6 (P2)
unnamed: R71.1, U33.7 (P3)
unnamed: R72.1, U33.9 (P4)
unnamed: R73.1, U33.10 (P5)
unnamed: R74.1, U33.11 (P6)
unnamed: R75.1, U33.12 (P7)
unnamed: TP8.1, U33.13 (~INT)
VDESAFED: R58.1; also elsewhere on the board
Vdrive: R56.1; also elsewhere on the board

Notes on the sheet:
Check-feedback channel
Indicator LEDs
Buffer for LEDs
1nF cap to eliminate oscillations
Voltage detection CH1
I2C address: 0100 A2 A1 A0 Currently wired for 0x22
Check-hot
Set GPIO to high-Z input mode
Voltage detection CH2
Check-hot channel
Assuming forward voltage of 2V, ~2.8mA per LED
20k and 47k divide 3.3V down to 1V for comparator reference
Divides Vdrive (20-28V) down to 2.3-3.2V. Buffer considers A > 2V to be HIGH state, so channel turns on if the hot actuator power is >17V.
Check-safe channel
~6.3mA LED drive per channel Up to 55mA total from 3.3V_ACT Output on FB_CHx is inverted, 3mA max
Feedback Isolators
External CH2
External CH1
GPIO expander for feedback
Adjustable VDET threshold detector. Higher potentiometer values correspond to lower thresholds. Lowest threshold is 11V.
Check-feedback
External CH3
Divides VDESAFED (20-28V) down to 2.3-3.2V. Buffer considers A > 2V to be HIGH state, so channel turns on if the hot actuator power is >17V.
Check-safe
Feedback Logic

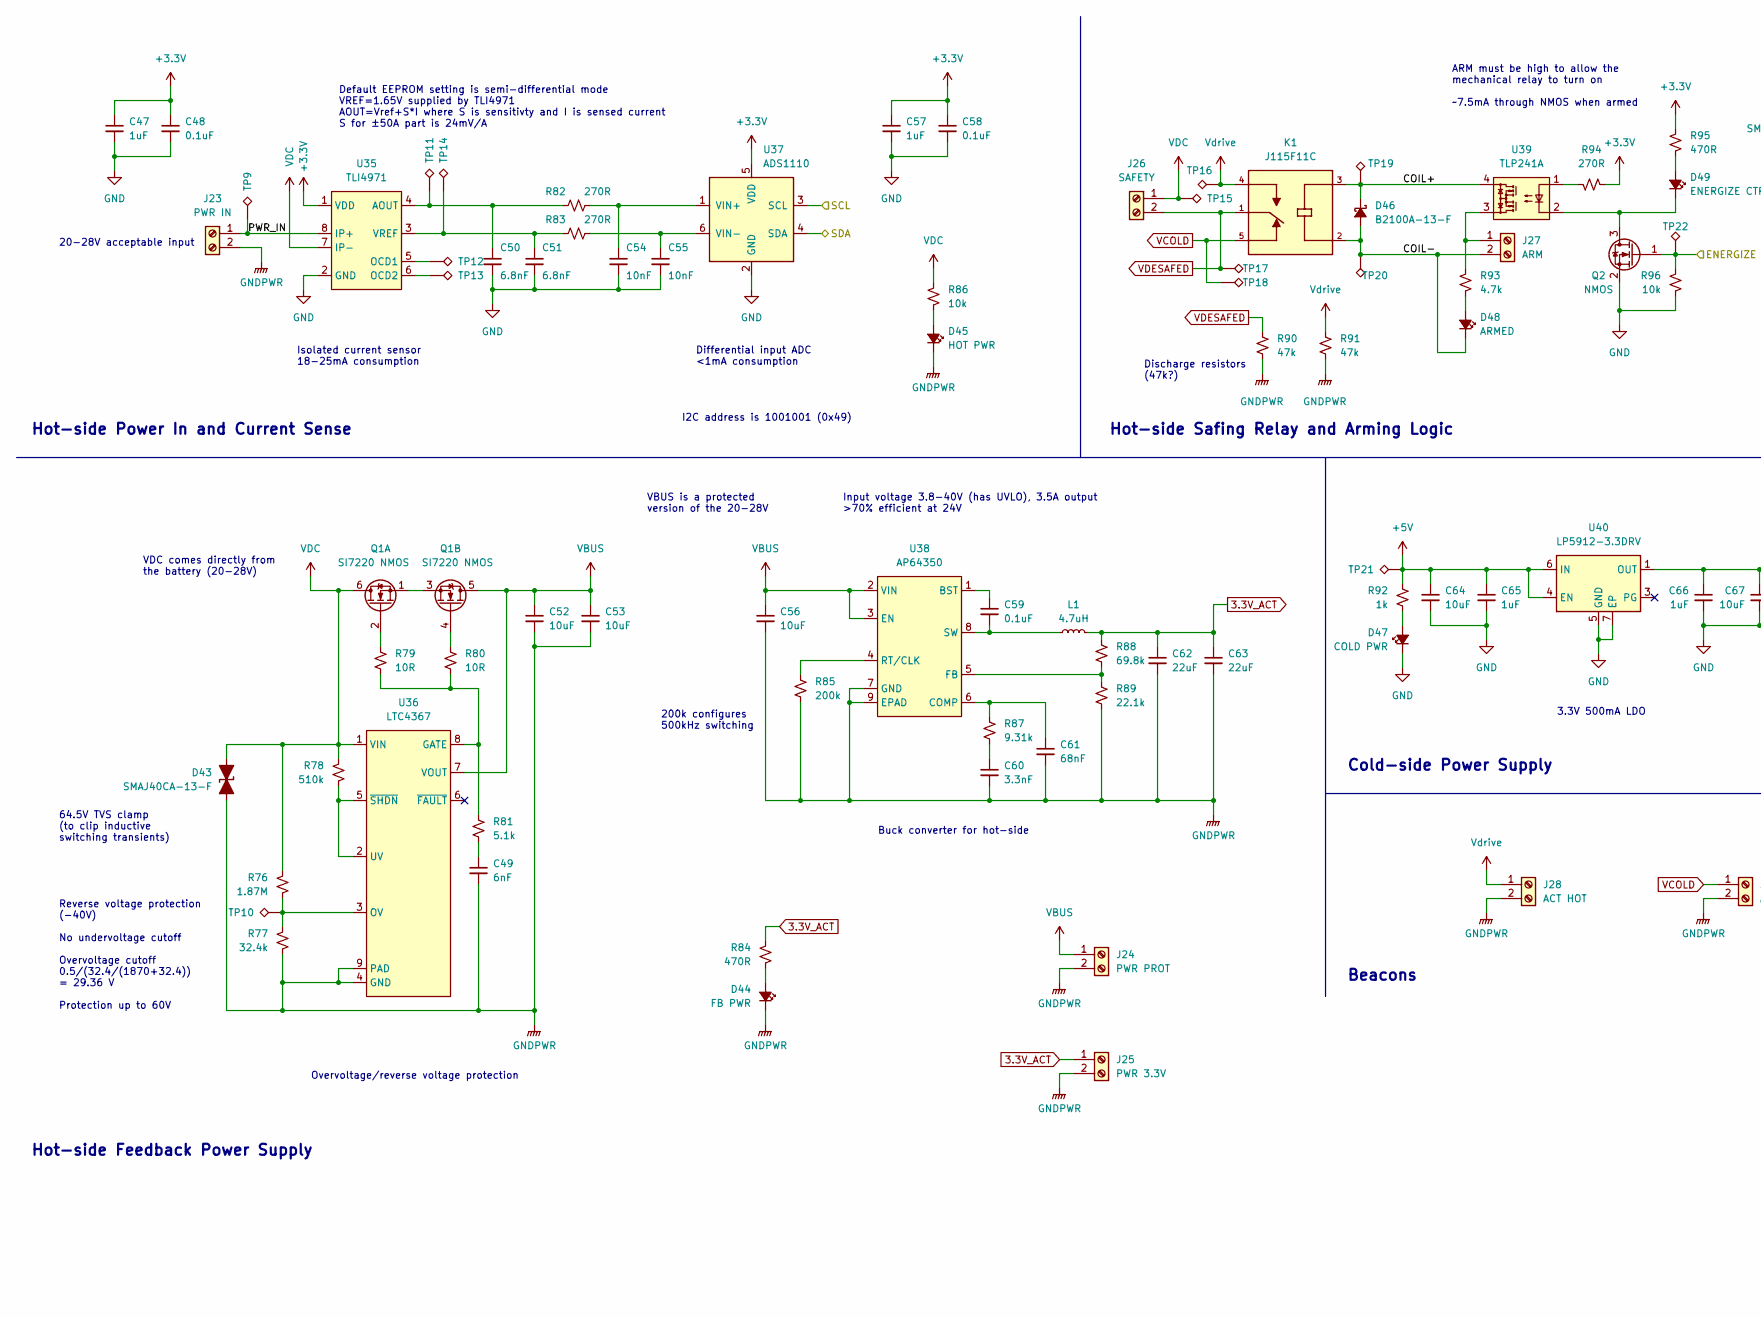
[picture p23: schematic power.kicad_sch, part in row 1, column 1]

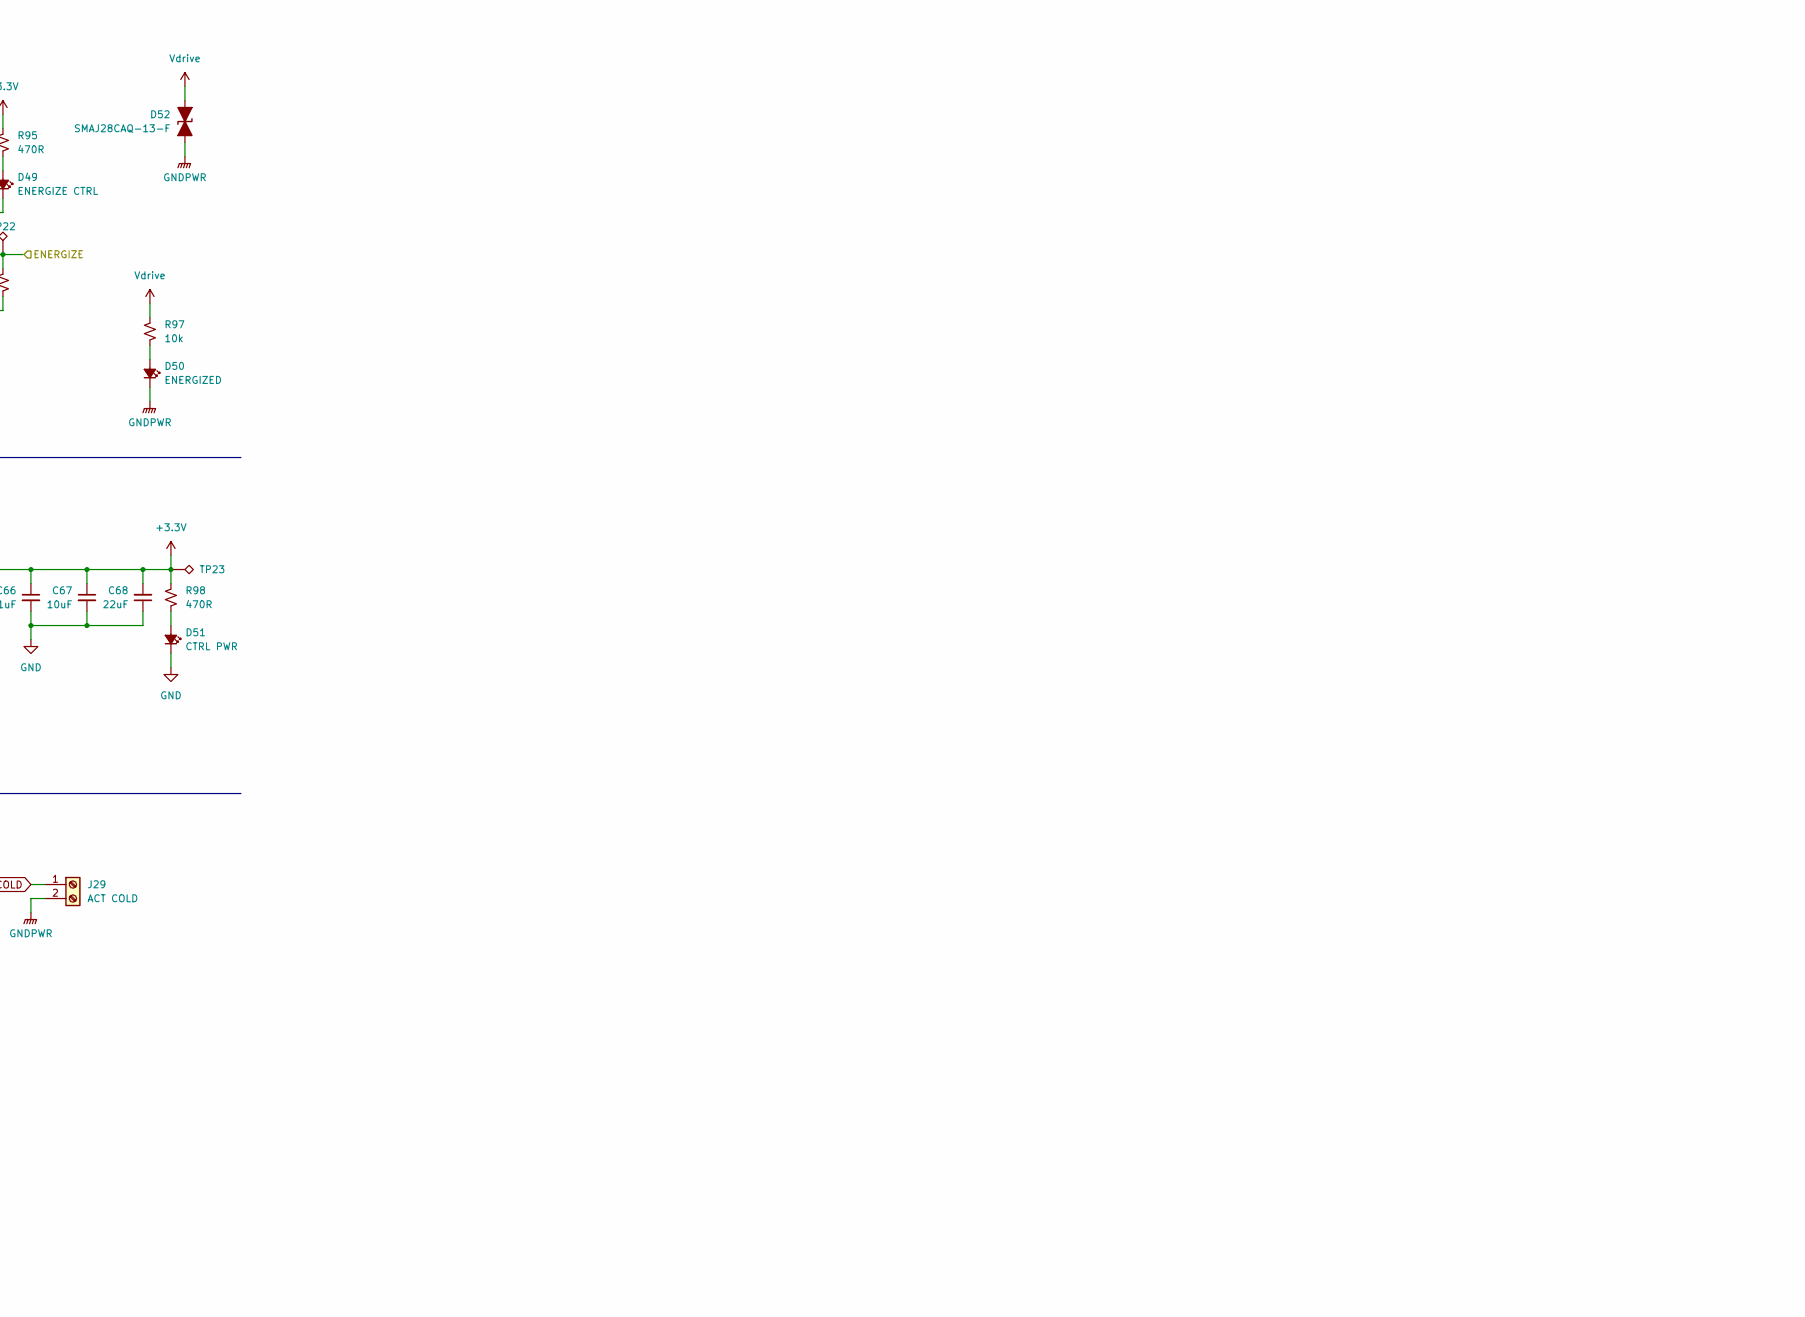
[picture p24: schematic power.kicad_sch, part in row 1, column 2]

Parts:
C47, C57, C65, C66: 1uF; C_0603_1608Metric
C48, C58, C59: 0.1uF; C_0603_1608Metric
C49: 6nF; C_0603_1608Metric; MPN CL10C060DB8NNNC
C50, C51: 6.8nF; C_0603_1608Metric
C52, C53, C56: 10uF; C_1206_3216Metric; MPN CL31B106KBHNNNE
C54, C55: 10nF; C_0603_1608Metric
C60: 3.3nF; C_0603_1608Metric
C61: 68nF; C_0603_1608Metric
C62, C63, C68: 22uF; C_1206_3216Metric
C64, C67: 10uF; C_0805_2012Metric
D43: SMAJ40CA-13-F; D_SMA; MPN SMAJ40CA-13-F
D44: FB PWR; LED_0603_1608Metric; MPN LTST-C191KGKT
D45: HOT PWR; LED_0603_1608Metric; MPN LTST-C191KGKT
D46: B2100A-13-F; D_SMA; MPN B2100A-13-F
D47: COLD PWR; LED_0603_1608Metric; MPN LTST-C191KGKT
D48: ARMED; LED_0603_1608Metric; MPN LTST-C191KRKT
D49: ENERGIZE CTRL; LED_0603_1608Metric; MPN LTST-C191KRKT
D50: ENERGIZED; LED_0603_1608Metric; MPN LTW-C191DS5
D51: CTRL PWR; LED_0603_1608Metric; MPN LTST-C191KGKT
D52: SMAJ28CAQ-13-F; D_SMA; MPN SMAJ28CAQ-13-F
J23: PWR IN; XT90PW-M; MPN XT90PW-M
J24: PWR PROT; AMASS_XT60-M_1x02_P7.20mm_Vertical; MPN XT60-M
J25: PWR 3.3V; AMASS_XT60-M_1x02_P7.20mm_Vertical; MPN XT60-M
J26: SAFETY; XT90PW-M; MPN XT90PW-M
J27: ARM; AMASS_XT60-M_1x02_P7.20mm_Vertical; MPN XT60-M
J28: ACT HOT; AMASS_XT60-M_1x02_P7.20mm_Vertical; MPN XT60-M
J29: ACT COLD; AMASS_XT60-M_1x02_P7.20mm_Vertical; MPN XT60-M
K1: J115F11C; MPN J115F11CH12VDCSH1.5U
L1: 4.7uH; L_Vishay_IHLP-2020; MPN IHLP2020CZER4R7M11
Q1: SI7220 NMOS; Vishay_PowerPAK_1212-8_Dual; MPN SI7220DN-T1-GE3
Q2: NMOS; SOT-23-3; MPN PMV40UN2R
R76: 1.87M; R_0603_1608Metric; MPN RC0603FR-071M87L
R77: 32.4k; R_0603_1608Metric; MPN RT0603BRD0732K4L
R78: 510k; R_0603_1608Metric; MPN RC0603FR-07510KL
R79, R80: 10R; R_0603_1608Metric; MPN RC0603FR-0710RL
R81: 5.1k; R_0603_1608Metric
R82, R83, R94: 270R; R_0603_1608Metric; MPN RC0603FR-07270RL
R84, R95, R98: 470R; R_0603_1608Metric
R85: 200k; R_0603_1608Metric
R86, R96, R97: 10k; R_0603_1608Metric
R87: 9.31k; R_0603_1608Metric
R88: 69.8k; R_0603_1608Metric
R89: 22.1k; R_0603_1608Metric
R90, R91: 47k; R_0603_1608Metric
R92: 1k; R_0603_1608Metric
R93: 4.7k; R_0603_1608Metric
TP9, TP10, TP11, TP12, TP13, TP14, TP15, TP16, TP17, TP18, TP19, TP20, TP21, TP22, TP23: TestPoint_Alt; TestPoint_Pad_D2.0mm
U35: TLI4971; Infineon_PG-TISON-8-5; MPN TLI4971A050T5UE0001XUMA1
U36: LTC4367; DFN-8-1EP_3x3mm_P0.5mm_EP1.65x2.38mm; MPN LTC4367IDD-1#PBF
U37: ADS1110; SOT-23-6; MPN ADS1110A1IDBVT
U38: AP64350; SOIC-8-1EP_3.9x4.9mm_P1.27mm_EP2.62x3.51mm; MPN AP64350SP-13
U39: TLP241A; MPN TLP241A(TP1,F
U40: LP5912-3.3DRV; WSON-6-1EP_2x2mm_P0.65mm_EP1x1.6mm; MPN LP5912-3.3DRVR

Connections:
3.3V_ACT: C62.1, C63.1, J25.1, L1.2, R84.1, R88.1; also elsewhere on the board
+3.3V: C47.1, C48.1, C57.1, C58.1, C66.1, C67.1, C68.2, R94.1, R95.1, R98.1, TP23.1, U35.1 (VDD), U37.5 (VDD), U40.1 (OUT); also elsewhere on the board
+5V: C64.1, C65.1, R92.1, TP21.1, U40.4 (EN), U40.6 (IN); also elsewhere on the board
/ENERGIZE: Q2.1 (G), R96.1, TP22.1; also elsewhere on the board
/Power/COIL+: D46.1 (K), K1.3, TP19.1, U39.4
/Power/COIL-: D46.2 (A), D48.1 (K), J27.2, K1.2, TP20.1
/Power/PWR_IN: J23.1, TP9.1, U35.8 (IP+)
/SCL: U37.3 (SCL); also elsewhere on the board
/SDA: U37.4 (SDA); also elsewhere on the board
GND: C47.2, C48.2, C50.2, C51.2, C54.2, C55.2, C57.2, C58.2, C64.2, C65.2, C66.2, C67.2, C68.1, D47.1 (K), D51.1 (K), Q2.2 (S), R96.2, U35.2 (GND), U37.2 (GND), U40.5 (GND), U40.7 (EP); also elsewhere on the board
GNDPWR: C49.2, C52.2, C53.2, C56.2, C60.2, C61.2, C62.2, C63.2, D43.1 (A1), D44.1 (K), D45.1 (K), D50.1 (K), D52.1 (A1), J23.2, J24.2, J25.2, J28.2, J29.2, R77.1, R85.2, R89.2, R90.2, R91.2, U36.4 (GND), U36.9 (PAD), U38.7 (GND), U38.9 (EPAD); also elsewhere on the board
unnamed: C49.1, R81.2
unnamed: C50.1, R82.1, TP11.1, U35.4 (AOUT)
unnamed: C51.1, R83.1, TP14.1, U35.3 (VREF)
unnamed: C54.1, R82.2, U37.1 (VIN+)
unnamed: C55.1, R83.2, U37.6 (VIN-)
unnamed: C59.1, U38.1 (BST)
unnamed: C59.2, L1.1, U38.8 (SW)
unnamed: C60.1, R87.2
unnamed: C61.1, R87.1, U38.6 (COMP)
unnamed: D44.2 (A), R84.2
unnamed: D45.2 (A), R86.2
unnamed: D47.2 (A), R92.2
unnamed: D48.2 (A), R93.2
unnamed: D49.1 (K), Q2.3 (D), U39.2
unnamed: D49.2 (A), R95.2
unnamed: D50.2 (A), R97.2
unnamed: D51.2 (A), R98.2
unnamed: J27.1, R93.1, U39.3
unnamed: Q1.1 (S), Q1.3 (S)
unnamed: Q1.2 (G), R79.1
unnamed: Q1.4 (G), R80.1
unnamed: R76.1, R77.2, TP10.1, U36.3 (OV)
unnamed: R78.1, U36.2 (UV), U36.5 (~SHDN)
unnamed: R79.2, R80.2, R81.1, U36.8 (GATE)
unnamed: R85.1, U38.4 (RT/CLK)
unnamed: R88.2, R89.1, U38.5 (FB)
unnamed: R94.2, U39.1
unnamed: TP12.1, U35.5 (OCD1)
unnamed: TP13.1, U35.6 (OCD2)
VBUS: C52.1, C53.1, C56.1, J24.1, Q1.5 (D), U36.7 (VOUT), U38.2 (VIN), U38.3 (EN)
VCOLD: J29.1, K1.5, TP18.1
VDC: D43.2 (A2), J26.1, Q1.6 (D), R76.2, R78.2, R86.1, TP15.1, U35.7 (IP-), U36.1 (VIN)
VDESAFED: J26.2, K1.1, R90.1, TP17.1; also elsewhere on the board
Vdrive: D52.2 (A2), J28.1, K1.4, R91.1, R97.1, TP16.1; also elsewhere on the board

Notes on the sheet:
Hot-side Feedback Power Supply
64.5V TVS clamp (to clip inductive switching transients)
Input voltage 3.8-40V (has UVLO), 3.5A output >70% efficient at 24V
VBUS is a protected version of the 20-28V
Isolated current sensor 18-25mA consumption
Cold-side Power Supply
Differential input ADC <1mA consumption
3.3V 500mA LDO
Buck converter for hot-side
Overvoltage/reverse voltage protection
VDC comes directly from the battery (20-28V)
200k configures 500kHz switching
Hot-side Power In and Current Sense
I2C address is 1001001 (0x49)
Beacons
Reverse voltage protection (-40V) No undervoltage cutoff Overvoltage cutoff 0.5/(32.4/(1870+32.4)) = 29.36 V Protection up to 60V
20-28V acceptable input
Hot-side Safing Relay and Arming Logic
ARM must be high to allow the mechanical relay to turn on ~7.5mA through NMOS when armed
Default EEPROM setting is semi-differential mode VREF=1.65V supplied by TLI4971 AOUT=Vref+S*I where S is sensitivty and I is sensed current S for ±50A part is 24mV/A
Discharge resistors (47k?)
