liquid-rocketry-illinois/actuation-pcb/actuation.kicad_pcb

## KiCad design actuation.kicad_pcb (continued)

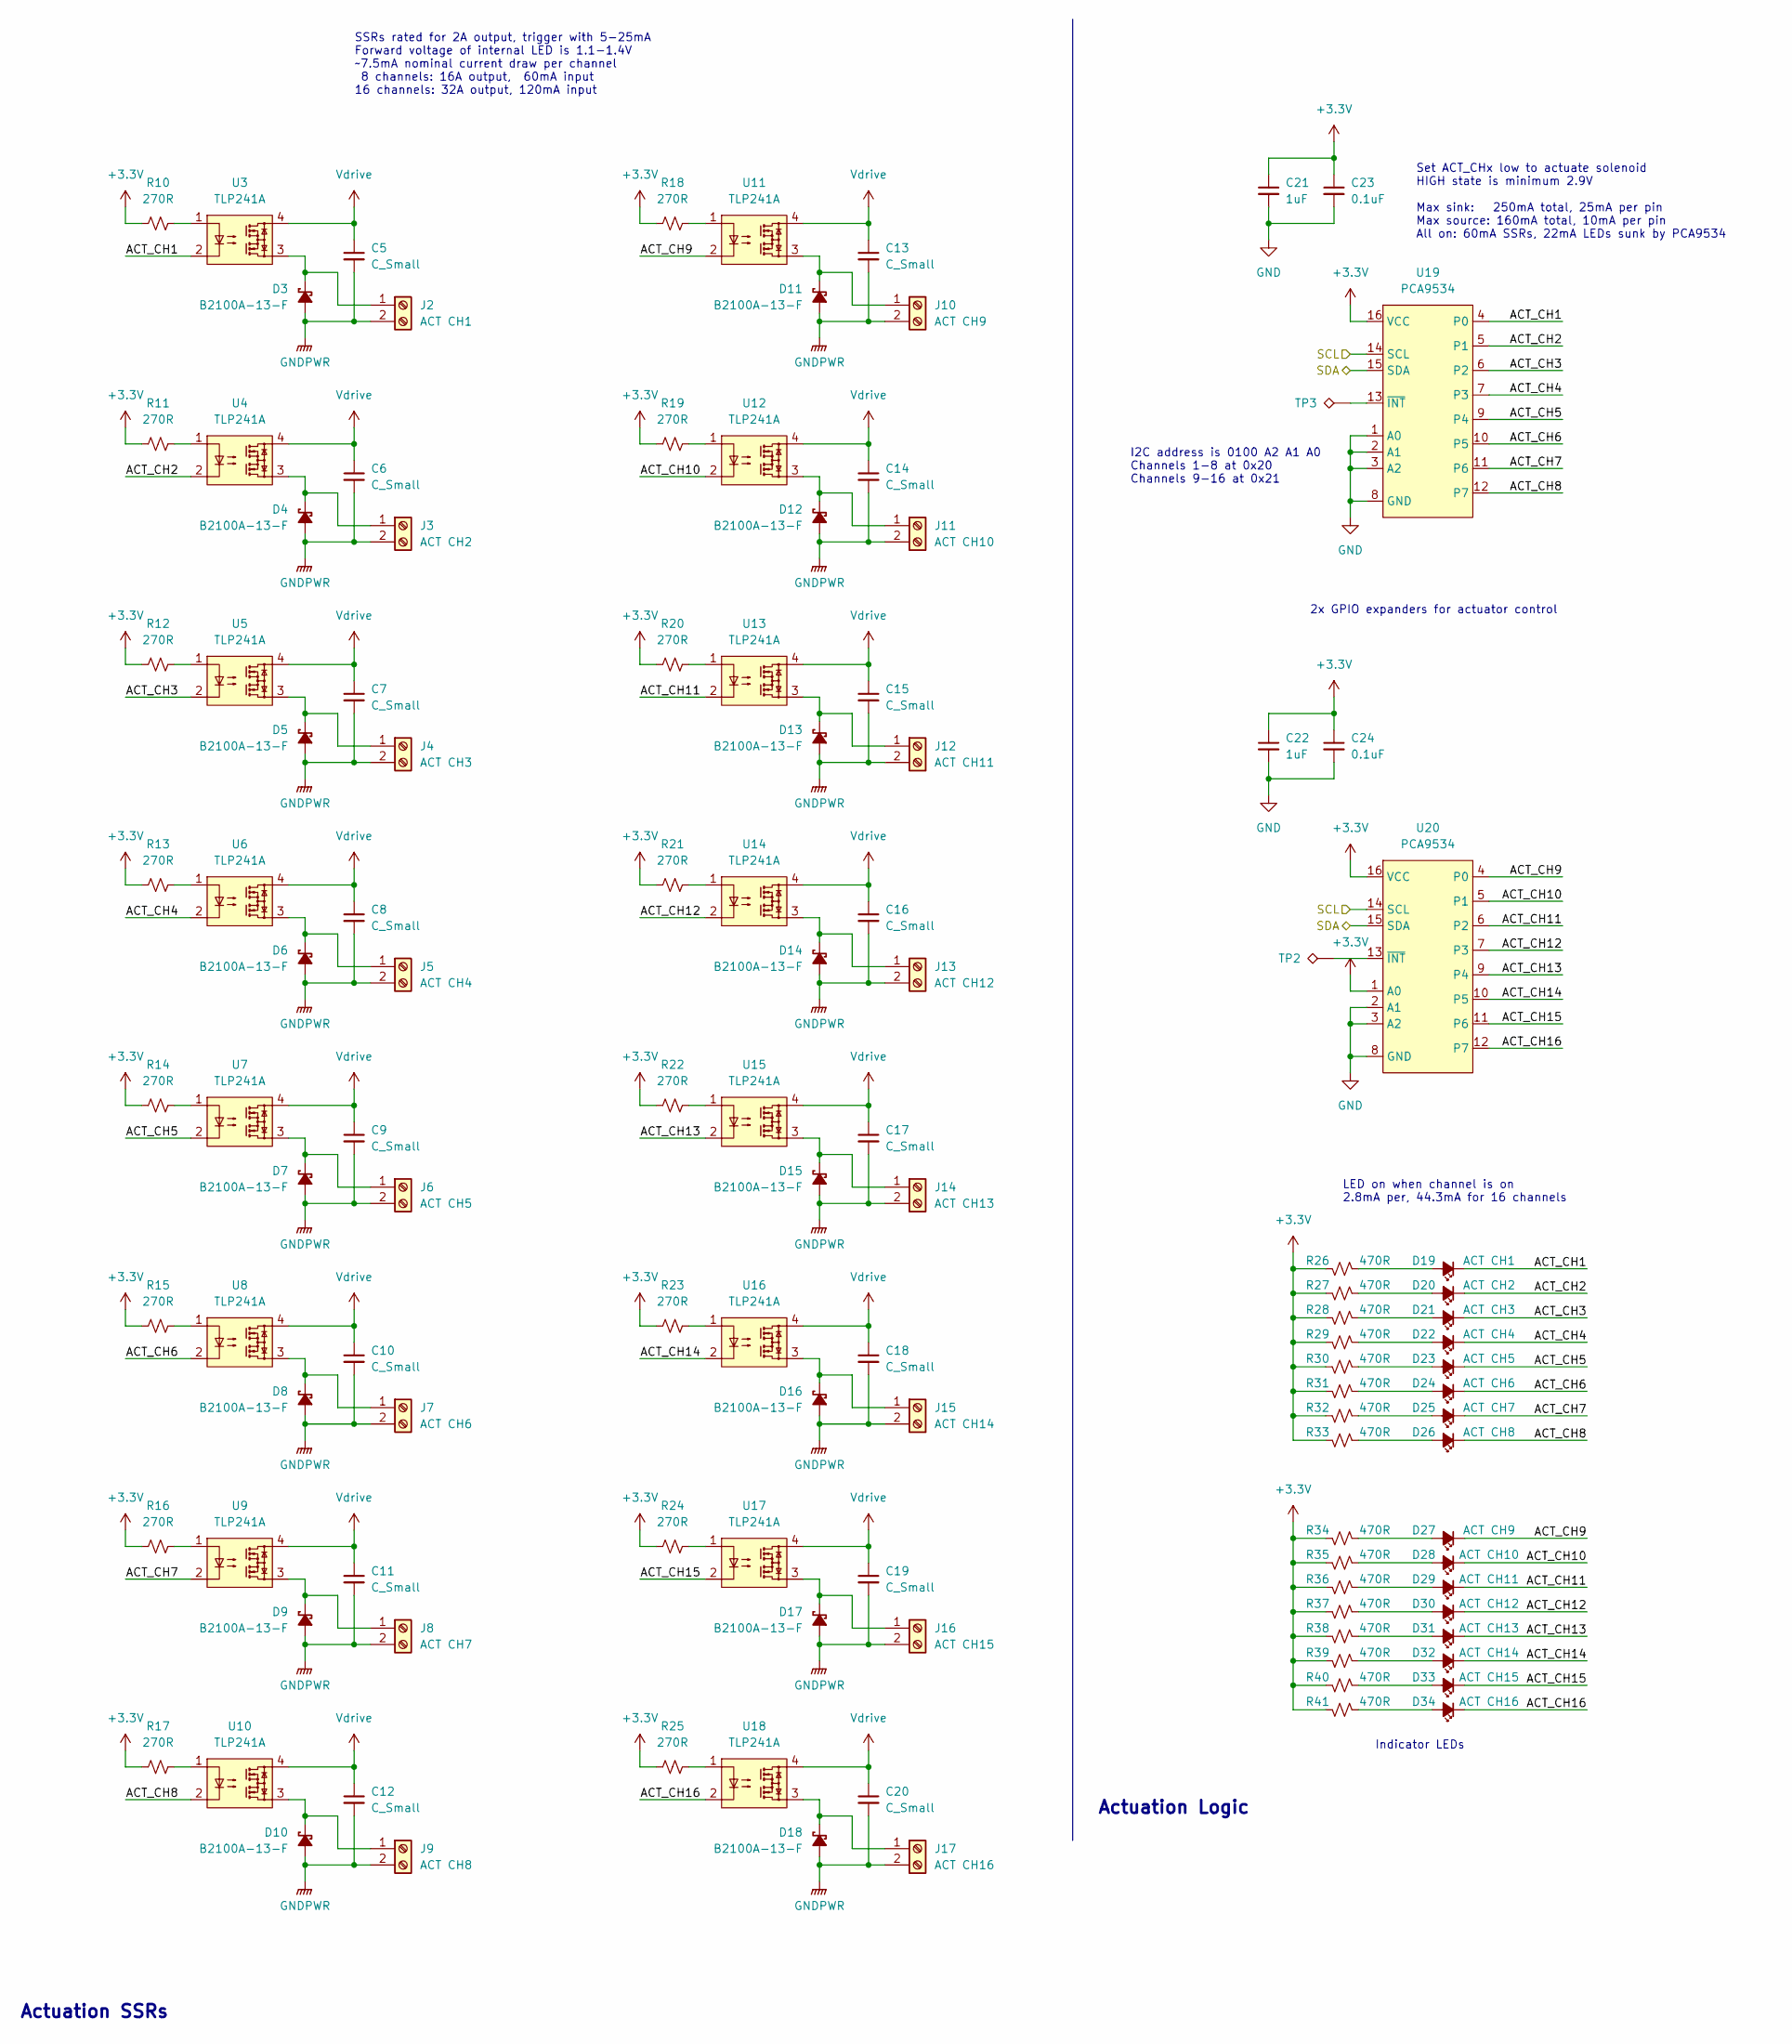
[picture p25: schematic actuatorchannels.kicad_sch]

Parts:
C5, C6, C7, C8, C9, C10, C11, C12, C13, C14, C15, C16, C17, C18, C19, C20: C_Small; C_1210_3225Metric; MPN CL32B106KBJNNWE
C21, C22: 1uF; C_0603_1608Metric
C23, C24: 0.1uF; C_0603_1608Metric
D3, D4, D5, D6, D7, D8, D9, D10, D11, D12, D13, D14, D15, D16, D17, D18: B2100A-13-F; D_SMA; MPN B2100A-13-F
D19: ACT CH1; LED_0603_1608Metric; MPN LTST-C191KFKT
D20: ACT CH2; LED_0603_1608Metric; MPN LTST-C191KFKT
D21: ACT CH3; LED_0603_1608Metric; MPN LTST-C191KFKT
D22: ACT CH4; LED_0603_1608Metric; MPN LTST-C191KFKT
D23: ACT CH5; LED_0603_1608Metric; MPN LTST-C191KFKT
D24: ACT CH6; LED_0603_1608Metric; MPN LTST-C191KFKT
D25: ACT CH7; LED_0603_1608Metric; MPN LTST-C191KFKT
D26: ACT CH8; LED_0603_1608Metric; MPN LTST-C191KFKT
D27: ACT CH9; LED_0603_1608Metric; MPN LTST-C191KFKT
D28: ACT CH10; LED_0603_1608Metric; MPN LTST-C191KFKT
D29: ACT CH11; LED_0603_1608Metric; MPN LTST-C191KFKT
D30: ACT CH12; LED_0603_1608Metric; MPN LTST-C191KFKT
D31: ACT CH13; LED_0603_1608Metric; MPN LTST-C191KFKT
D32: ACT CH14; LED_0603_1608Metric; MPN LTST-C191KFKT
D33: ACT CH15; LED_0603_1608Metric; MPN LTST-C191KFKT
D34: ACT CH16; LED_0603_1608Metric; MPN LTST-C191KFKT
J2: ACT CH1; XT30U-M; MPN XT30U-M
J3: ACT CH2; XT30U-M; MPN XT30U-M
J4: ACT CH3; XT30U-M; MPN XT30U-M
J5: ACT CH4; XT30U-M; MPN XT30U-M
J6: ACT CH5; XT30U-M; MPN XT30U-M
J7: ACT CH6; XT30U-M; MPN XT30U-M
J8: ACT CH7; XT30U-M; MPN XT30U-M
J9: ACT CH8; XT30U-M; MPN XT30U-M
J10: ACT CH9; XT30U-M; MPN XT30U-M
J11: ACT CH10; XT30U-M; MPN XT30U-M
J12: ACT CH11; XT30U-M; MPN XT30U-M
J13: ACT CH12; XT30U-M; MPN XT30U-M
J14: ACT CH13; XT30U-M; MPN XT30U-M
J15: ACT CH14; XT30U-M; MPN XT30U-M
J16: ACT CH15; XT30U-M; MPN XT30U-M
J17: ACT CH16; XT30U-M; MPN XT30U-M
R10, R11, R12, R13, R14, R15, R16, R17, R18, R19, R20, R21, R22, R23, R24, R25: 270R; R_0603_1608Metric; MPN RC0603FR-07270RL
R26, R27, R28, R29, R30, R31, R32, R33, R34, R35, R36, R37, R38, R39, R40, R41: 470R; R_0603_1608Metric
TP2, TP3: TestPoint_Alt; TestPoint_Pad_D2.0mm
U3, U4, U5, U6, U7, U8, U9, U10, U11, U12, U13, U14, U15, U16, U17, U18: TLP241A; MPN TLP241A(TP1,F
U19, U20: PCA9534; TSSOP-16_4.4x5mm_P0.65mm; MPN PCA9534PWR

Connections:
+3.3V: C21.1, C22.1, C23.1, C24.1, R10.1, R11.1, R12.1, R13.1, R14.1, R15.1, R16.1, R17.1, R18.1, R19.1, R20.1, R21.1, R22.1, R23.1, R24.1, R25.1, R26.1, R27.1, R28.1, R29.1, R30.1, R31.1, R32.1, R33.1, R34.1, R35.1, R36.1, R37.1, R38.1, R39.1, R40.1, R41.1, U19.16 (VCC), U20.1 (A0), U20.16 (VCC); also elsewhere on the board
/Actuator Channels/ACT_CH1: D19.1 (K), U3.2, U19.4 (P0)
/Actuator Channels/ACT_CH2: D20.1 (K), U4.2, U19.5 (P1)
/Actuator Channels/ACT_CH3: D21.1 (K), U5.2, U19.6 (P2)
/Actuator Channels/ACT_CH4: D22.1 (K), U6.2, U19.7 (P3)
/Actuator Channels/ACT_CH5: D23.1 (K), U7.2, U19.9 (P4)
/Actuator Channels/ACT_CH6: D24.1 (K), U8.2, U19.10 (P5)
/Actuator Channels/ACT_CH7: D25.1 (K), U9.2, U19.11 (P6)
/Actuator Channels/ACT_CH8: D26.1 (K), U10.2, U19.12 (P7)
/Actuator Channels/ACT_CH9: D27.1 (K), U11.2, U20.4 (P0)
/Actuator Channels/ACT_CH10: D28.1 (K), U12.2, U20.5 (P1)
/Actuator Channels/ACT_CH11: D29.1 (K), U13.2, U20.6 (P2)
/Actuator Channels/ACT_CH12: D30.1 (K), U14.2, U20.7 (P3)
/Actuator Channels/ACT_CH13: D31.1 (K), U15.2, U20.9 (P4)
/Actuator Channels/ACT_CH14: D32.1 (K), U16.2, U20.10 (P5)
/Actuator Channels/ACT_CH15: D33.1 (K), U17.2, U20.11 (P6)
/Actuator Channels/ACT_CH16: D34.1 (K), U18.2, U20.12 (P7)
/SCL: U19.14 (SCL), U20.14 (SCL); also elsewhere on the board
/SDA: U19.15 (SDA), U20.15 (SDA); also elsewhere on the board
GND: C21.2, C22.2, C23.2, C24.2, U19.1 (A0), U19.2 (A1), U19.3 (A2), U19.8 (GND), U20.2 (A1), U20.3 (A2), U20.8 (GND); also elsewhere on the board
GNDPWR: C5.2, C6.2, C7.2, C8.2, C9.2, C10.2, C11.2, C12.2, C13.2, C14.2, C15.2, C16.2, C17.2, C18.2, C19.2, C20.2, D3.2 (A), D4.2 (A), D5.2 (A), D6.2 (A), D7.2 (A), D8.2 (A), D9.2 (A), D10.2 (A), D11.2 (A), D12.2 (A), D13.2 (A), D14.2 (A), D15.2 (A), D16.2 (A), D17.2 (A), D18.2 (A), J2.2, J3.2, J4.2, J5.2, J6.2, J7.2, J8.2, J9.2, J10.2, J11.2, J12.2, J13.2, J14.2, J15.2, J16.2, J17.2; also elsewhere on the board
unnamed: D3.1 (K), J2.1, U3.3
unnamed: D4.1 (K), J3.1, U4.3
unnamed: D5.1 (K), J4.1, U5.3
unnamed: D6.1 (K), J5.1, U6.3
unnamed: D7.1 (K), J6.1, U7.3
unnamed: D8.1 (K), J7.1, U8.3
unnamed: D9.1 (K), J8.1, U9.3
unnamed: D10.1 (K), J9.1, U10.3
unnamed: D11.1 (K), J10.1, U11.3
unnamed: D12.1 (K), J11.1, U12.3
unnamed: D13.1 (K), J12.1, U13.3
unnamed: D14.1 (K), J13.1, U14.3
unnamed: D15.1 (K), J14.1, U15.3
unnamed: D16.1 (K), J15.1, U16.3
unnamed: D17.1 (K), J16.1, U17.3
unnamed: D18.1 (K), J17.1, U18.3
unnamed: D19.2 (A), R26.2
unnamed: D20.2 (A), R27.2
unnamed: D21.2 (A), R28.2
unnamed: D22.2 (A), R29.2
unnamed: D23.2 (A), R30.2
unnamed: D24.2 (A), R31.2
unnamed: D25.2 (A), R32.2
unnamed: D26.2 (A), R33.2
unnamed: D27.2 (A), R34.2
unnamed: D28.2 (A), R35.2
unnamed: D29.2 (A), R36.2
unnamed: D30.2 (A), R37.2
unnamed: D31.2 (A), R38.2
unnamed: D32.2 (A), R39.2
unnamed: D33.2 (A), R40.2
unnamed: D34.2 (A), R41.2
unnamed: R10.2, U3.1
unnamed: R11.2, U4.1
unnamed: R12.2, U5.1
unnamed: R13.2, U6.1
unnamed: R14.2, U7.1
unnamed: R15.2, U8.1
unnamed: R16.2, U9.1
unnamed: R17.2, U10.1
unnamed: R18.2, U11.1
unnamed: R19.2, U12.1
unnamed: R20.2, U13.1
unnamed: R21.2, U14.1
unnamed: R22.2, U15.1
unnamed: R23.2, U16.1
unnamed: R24.2, U17.1
unnamed: R25.2, U18.1
unnamed: TP2.1, U20.13 (~INT)
unnamed: TP3.1, U19.13 (~INT)
Vdrive: C5.1, C6.1, C7.1, C8.1, C9.1, C10.1, C11.1, C12.1, C13.1, C14.1, C15.1, C16.1, C17.1, C18.1, C19.1, C20.1, U3.4, U4.4, U5.4, U6.4, U7.4, U8.4, U9.4, U10.4, U11.4, U12.4, U13.4, U14.4, U15.4, U16.4, U17.4, U18.4; also elsewhere on the board

Notes on the sheet:
LED on when channel is on 2.8mA per, 44.3mA for 16 channels
SSRs rated for 2A output, trigger with 5-25mA Forward voltage of internal LED is 1.1-1.4V ~7.5mA nominal current draw per channel 8 channels: 16A output, 60mA input 16 channels: 32A output, 120mA input
Indicator LEDs
Actuation Logic
Actuation SSRs
2x GPIO expanders for actuator control
I2C address is 0100 A2 A1 A0 Channels 1-8 at 0x20 Channels 9-16 at 0x21
Set ACT_CHx low to actuate solenoid HIGH state is minimum 2.9V Max sink: 250mA total, 25mA per pin Max source: 160mA total, 10mA per pin All on: 60mA SSRs, 22mA LEDs sunk by PCA9534

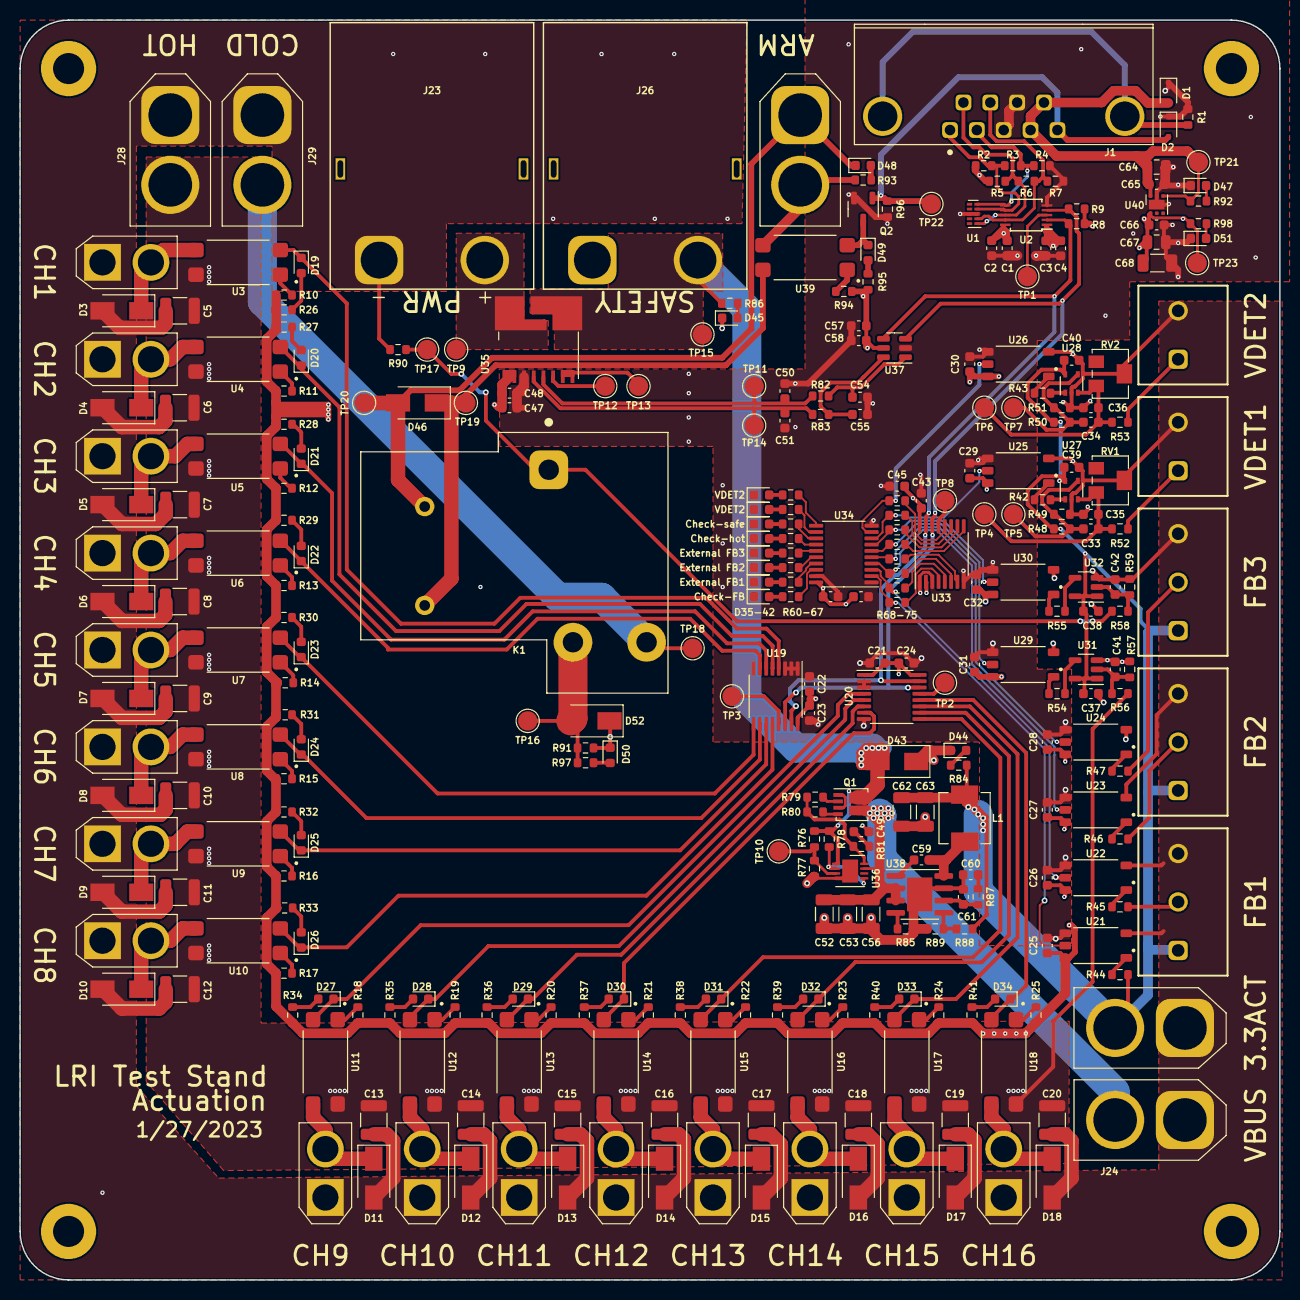
[picture p26: board actuation.kicad_pcb from above]

Board: 4 copper layers, 130.0 x 130.0 mm, 316 parts (0 on the bottom side), 173 nets.
