liquid-rocketry-illinois/actuation-pcb/(commit log)

2022-10-11 KiCAD starter files
    [actuation.kicad_pcb, actuation.kicad_sch]
2022-10-31 RI2C, digital isolator, currents sense symbols
    [actuation.kicad_pcb, actuation.kicad_sch]
2022-11-03 GPIO, ADC
    [actuation.kicad_sch]
2022-11-07 made symbols for ssr, optocoupler (missing footprint)
    [actuation.kicad_sch]
2022-11-14 Finished optocoupler, and ssr
    [actuation.kicad_sch]
2022-11-14 Worked on schematic, symbol placement weird
    [actuation.kicad_sch]
2022-12-13 Added more symbols to schematic
    [LimitSwitchExpander8.kicad_sch, SSRexpander8.kicad_sch, actuation.kicad_sch]
2022-12-14 Grid issues
    [LimitSwitchExpander8.kicad_sch, SSRexpander8.kicad_sch, actuation.kicad_sch]
2022-12-14 added db9 and 3.3buck
    [actuation.kicad_sch]
2022-12-31 Cleaned up J115F11C symbol
    [LimitSwitchExpander8.kicad_sch, SSRexpander8.kicad_sch, actuation.kicad_pcb, actuation.kicad_sch]
2022-12-31 Cleaned up TLP241A symbol
    [actuation.kicad_sch]
2023-01-01 Added TLV7031 symbol
    [actuation.kicad_sch]
2023-01-01 Added TPS70933 symbol
    [actuation.kicad_sch]
2023-01-01 Starting rework of schematic
    [actuation.kicad_sch, actuatorchannels.kicad_sch]
2023-01-01 Array of SSRs for actuation channels
    [actuation.kicad_sch, actuatorchannels.kicad_sch]
2023-01-01 Actuator channels complete
    [actuation.kicad_sch, actuatorchannels.kicad_sch]
2023-01-01 Array of isolators for feedback channels
    [actuation.kicad_sch, actuatorchannels.kicad_sch, feedbackchannels.kicad_sch]
2023-01-01 Progress on feedback channels
    [actuation.kicad_sch, feedbackchannels.kicad_sch]
2023-01-02 Voltage threshold detection feedback channels
    [actuation.kicad_sch, feedbackchannels.kicad_sch]
2023-01-02 Feedback channels and status LEDs
    [actuation.kicad_sch, feedbackchannels.kicad_sch]
2023-01-02 Power subsheet
    [actuation.kicad_sch, power.kicad_sch]
2023-01-02 Fixed actuator channels to make GPIO expander sink instead of source current
    [actuation.kicad_sch, actuatorchannels.kicad_sch, power.kicad_sch]
2023-01-02 Check-safe channel with buffer
    [actuation.kicad_sch, feedbackchannels.kicad_sch, power.kicad_sch]
2023-01-02 Preliminary power scheme
    [actuation.kicad_sch, feedbackchannels.kicad_sch, power.kicad_sch]
2023-01-02 Added actuation status LEDs
    [actuation.kicad_sch, actuatorchannels.kicad_sch]
2023-01-03 ADC filtering and decoupling for current sense
    [actuation.kicad_sch, power.kicad_sch]
2023-01-03 add text
    [feedbackchannels.kicad_sch]
2023-01-03 Created arming circuit controllable by C&C
    [actuation.kicad_sch, actuatorchannels.kicad_sch, feedbackchannels.kicad_sch, power.kicad_sch]
2023-01-03 Added hot-side supply protection
    [actuation.kicad_sch, feedbackchannels.kicad_sch, power.kicad_sch]
2023-01-03 Replaced hot-side feedback LDO with buck converter
    [actuation.kicad_sch, feedbackchannels.kicad_sch]
2023-01-03 Reorganizing schematic
    [actuation.kicad_sch, actuatorchannels.kicad_sch, feedbackchannels.kicad_sch, power.kicad_sch]
2023-01-03 More reorganizing
    [actuation.kicad_sch, actuatorchannels.kicad_sch, feedbackchannels.kicad_sch, power.kicad_sch]
2023-01-03 Terminal block part selections
    [actuation.kicad_sch, feedbackchannels.kicad_sch, power.kicad_sch]
2023-01-03 more notes, generate pdf
    [actuation.kicad_pcb, actuation.kicad_sch, actuatorchannels.kicad_sch, feedbackchannels.kicad_sch, power.kicad_sch]
2023-01-03 notes on feedback sheet
    [actuation.kicad_sch, feedbackchannels.kicad_sch]
2023-01-03 estimate 3.3V current consumption
    [actuation.kicad_sch, actuatorchannels.kicad_sch, feedbackchannels.kicad_sch, power.kicad_sch]
2023-01-03 schematic pdf
2023-01-03 labeled chips with their function
    [actuation.kicad_sch, actuatorchannels.kicad_sch, feedbackchannels.kicad_sch, power.kicad_sch]
2023-01-04 Added feedback indicator LED buffer and made changes to notes
    [actuation.kicad_pcb, actuation.kicad_sch, actuatorchannels.kicad_sch, feedbackchannels.kicad_sch, power.kicad_sch]
2023-01-04 Footprints, some part selection, external power outputs
    [1751248.step, 1751251.step, 1773976.step, actuation.kicad_sch, actuatorchannels.kicad_sch, feedbackchannels.kicad_sch, power.kicad_sch]
2023-01-04 Schematic reorganization
    [actuation.kicad_sch, actuatorchannels.kicad_sch, feedbackchannels.kicad_sch, power.kicad_sch]
2023-01-05 TVS diodes for ESD protection on inputs
    [actuation.kicad_sch, power.kicad_sch]
2023-01-05 Added power protection as well
    [actuation.kicad_sch]
2023-01-05 LED MPNs and new status indicator
    [actuation.kicad_sch, actuatorchannels.kicad_sch, feedbackchannels.kicad_sch, power.kicad_sch]
2023-01-05 Changed status LED configuration
    [actuation.kicad_sch, power.kicad_sch]
2023-01-05 Safing jumper, status LEDs, better naming of power states
    [actuation.kicad_sch, actuatorchannels.kicad_sch, feedbackchannels.kicad_sch, power.kicad_sch]
2023-01-06 Fixing up footprints
    [actuation.kicad_sch, feedbackchannels.kicad_sch, power.kicad_sch]
2023-01-06 More terminal block footprint work
2023-01-06 MPN reassignment
    [actuation.kicad_sch, actuatorchannels.kicad_sch, feedbackchannels.kicad_sch, power.kicad_sch]
2023-01-06 Added 3D models
    [182-009-213.step, IHLP2020.step, TLI4971.step, TLP2366.step, TLP241A.step, actuation.kicad_pcb]
2023-01-06 Experimentation with placement
    [actuation.kicad_pcb]
2023-01-06 More placement
    [actuation.kicad_pcb]
2023-01-07 Group components
    [actuation.kicad_pcb, actuation.kicad_sch, power.kicad_sch]
2023-01-11 Modified de-safing key arrangement
    [actuation.kicad_pcb, actuation.kicad_sch, power.kicad_sch]
2023-01-16 Check-safe channel, footprint changes
    [XT90PW-M-new.step, XT90PW-M.step, actuation.kicad_pcb, actuation.kicad_sch, actuatorchannels.kicad_sch, feedbackchannels.kicad_sch, power.kicad_sch]
2023-01-16 Discharge resistors
    [actuation.kicad_sch, power.kicad_sch]
2023-01-17 Test pads and TVS diode for drive voltage
    [actuation.kicad_sch, actuatorchannels.kicad_sch, feedbackchannels.kicad_sch, power.kicad_sch]
2023-01-22 placed power parts
    [actuation.kicad_pcb, actuation.kicad_sch, feedbackchannels.kicad_sch, power.kicad_sch]
2023-01-22 3D models, footprint updates, general board layout
    [1935161.step, 1935174.step, XT30U-M.step, actuation.kicad_pcb, actuation.kicad_sch, actuatorchannels.kicad_sch, feedbackchannels.kicad_sch, power.kicad_sch]
2023-01-23 arranged actuators, feedback
    [actuation.kicad_pcb]
2023-01-23 much denser, should be no stray footprints now
    [actuation.kicad_pcb]
2023-01-23 moved whole thing to center of page
    [actuation.kicad_pcb]
2023-01-24 arranged power supplies
    [actuation.kicad_pcb]
2023-01-24 roughly determine board outline
    [actuation.kicad_pcb, power.kicad_sch]
2023-01-26 Deleted some test points
    [actuation.kicad_sch, power.kicad_sch]
2023-01-27 130x130 and arranged feedback
    [3224W-1-103E.step, actuation.kicad_pcb, actuation.kicad_sch, actuatorchannels.kicad_sch, feedbackchannels.kicad_sch]
2023-01-27 1.5mm labels
    [actuation.kicad_pcb, actuation.kicad_sch, actuatorchannels.kicad_sch, feedbackchannels.kicad_sch, power.kicad_sch]
2023-01-27 2mm CHx labeling
    [actuation.kicad_pcb]
2023-01-27 routed a feedback leds
    [TLI4971A050T5UE0001XUMA1--3DModel-STEP-56544.step, actuation.kicad_pcb]
2023-01-27 copper power polygons
    [actuation.kicad_pcb, actuation.kicad_sch, actuatorchannels.kicad_sch, feedbackchannels.kicad_sch, power.kicad_sch]
2023-01-27 adjust a few silkscreens
    [actuation.kicad_pcb]
2023-01-30 Placement and silkscreen changes
    [actuation.kicad_pcb]
2023-02-25 routed supplies and feedback
    [SI7220DN-T1-GE3.step, actuation.kicad_pcb]
2023-03-01 feedback routing
    [actuation.kicad_pcb]
2023-03-01 almost all connected
    [actuation.kicad_pcb]
2023-03-01 everything connected
    [actuation.kicad_pcb]
2023-03-01 no drc errors, still need silkscreen and check current paths
    [actuation.kicad_pcb]
2023-03-02 cameron adjustments, 3.3 plane
    [actuation.kicad_pcb]
2023-03-04 moved some traces
    [actuation.kicad_pcb]
2023-03-05 fix silkscreens, planes
    [actuation.kicad_pcb]
2023-03-11 Small updates
    [actuation.kicad_pcb]
2023-03-13 stitching vias
    [actuation.kicad_pcb]
2023-03-22 Routing touch-ups, silkscreen changes, finalized labels, adjusted power planes
    [actuation.kicad_sch, actuatorchannels.kicad_sch, feedbackchannels.kicad_sch, power.kicad_sch]
2023-03-22 Gerbers and passive value update
    [actuation-B_Cu.gbl, actuation-B_Mask.gbs, actuation-B_Paste.gbp, actuation-Edge_Cuts.gm1, actuation-F_Cu.gtl, actuation-F_Mask.gts, actuation-F_Paste.gtp, actuation-F_Silkscreen.gto]
2023-04-03 Finishing up part selection
    [actuation.kicad_sch, actuatorchannels.kicad_sch, feedbackchannels.kicad_sch, power.kicad_sch]
2023-04-03 Updated BOM
    [actuation.kicad_sch, actuation.xlsx, actuation_raw.csv, power.kicad_sch]
2023-04-03 filled digikey mpn and inventory:
    [actuation.xlsx]
2023-04-05 Updated BOM for ordering
    [actuation.xlsx]
2024-07-15 generate schematic pdf
